baglia/ROSBOT-project/componenti/motori/linmot/1613658636852.jpg

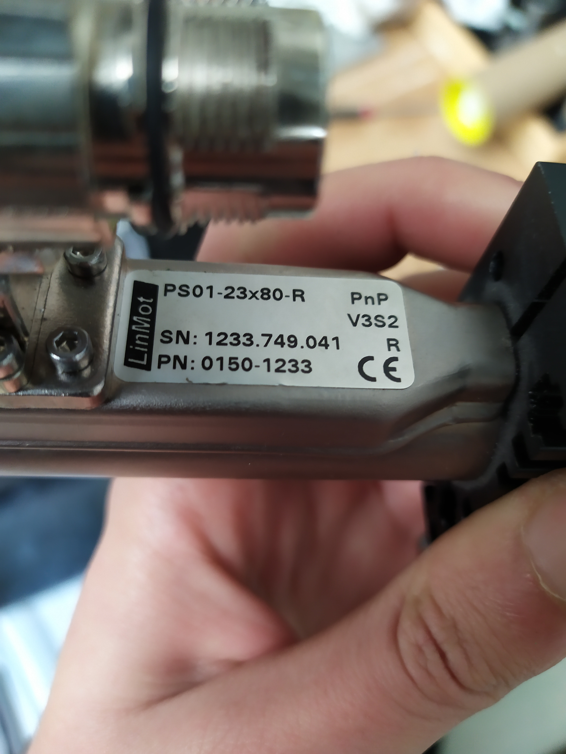
componenti/motori/linmot/1613658636852.jpg
