baglia/ROSBOT-project/README.md

# ROSBOT-project
 Francesco Baglioni e Francesco Campregher hanno realizzato un robot SCARA integrato con ROS come tesi di laurea triennale in ingegneria dell'automazione a UNIBS
