baglia/ROSBOT-project/componenti/motori/linmot/1613397983454.jpg

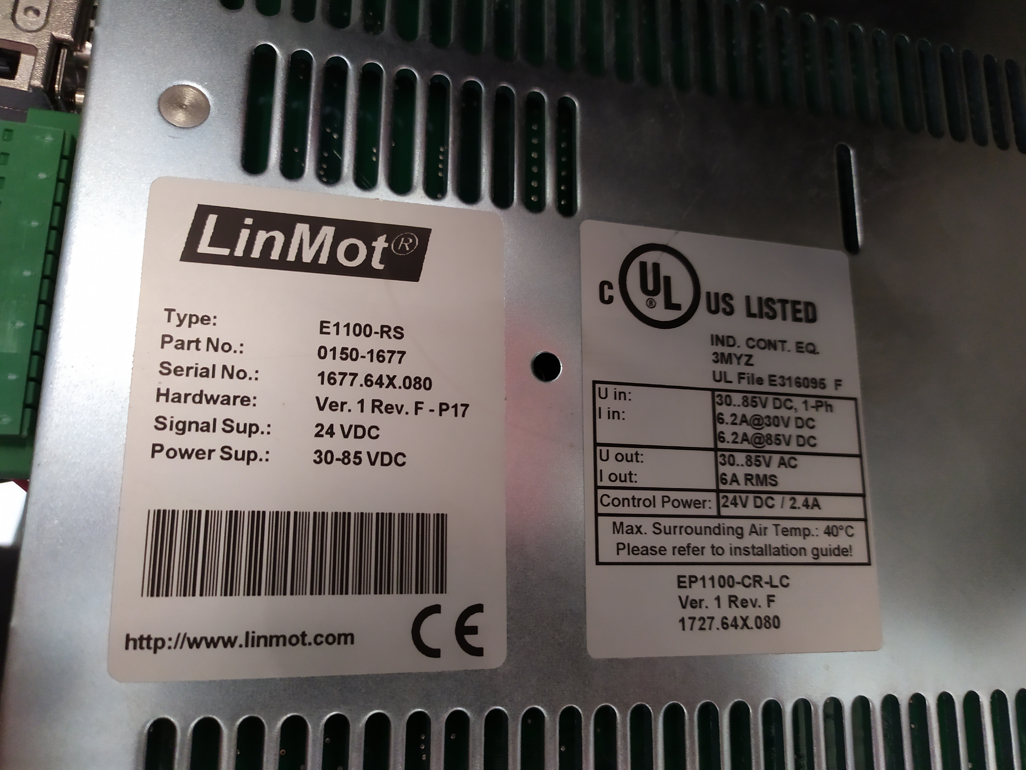
componenti/motori/linmot/1613397983454.jpg
