baglia/ROSBOT-project/componenti/motori/linmot/1613658636869.jpg

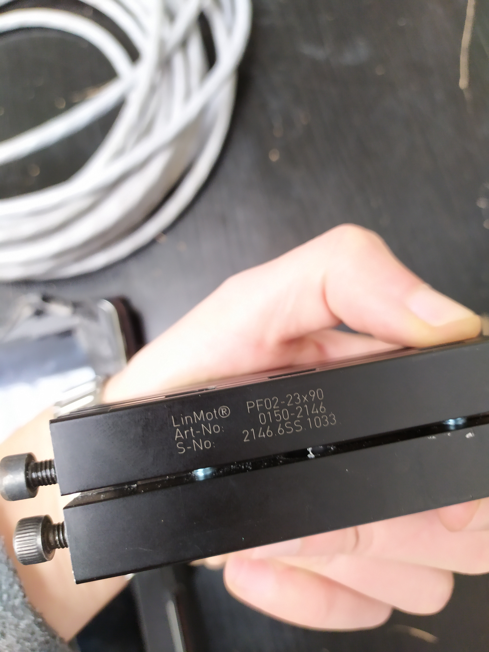
componenti/motori/linmot/1613658636869.jpg
