baglia/ROSBOT-project/componenti/motori/omron/mot-asse1.jpg

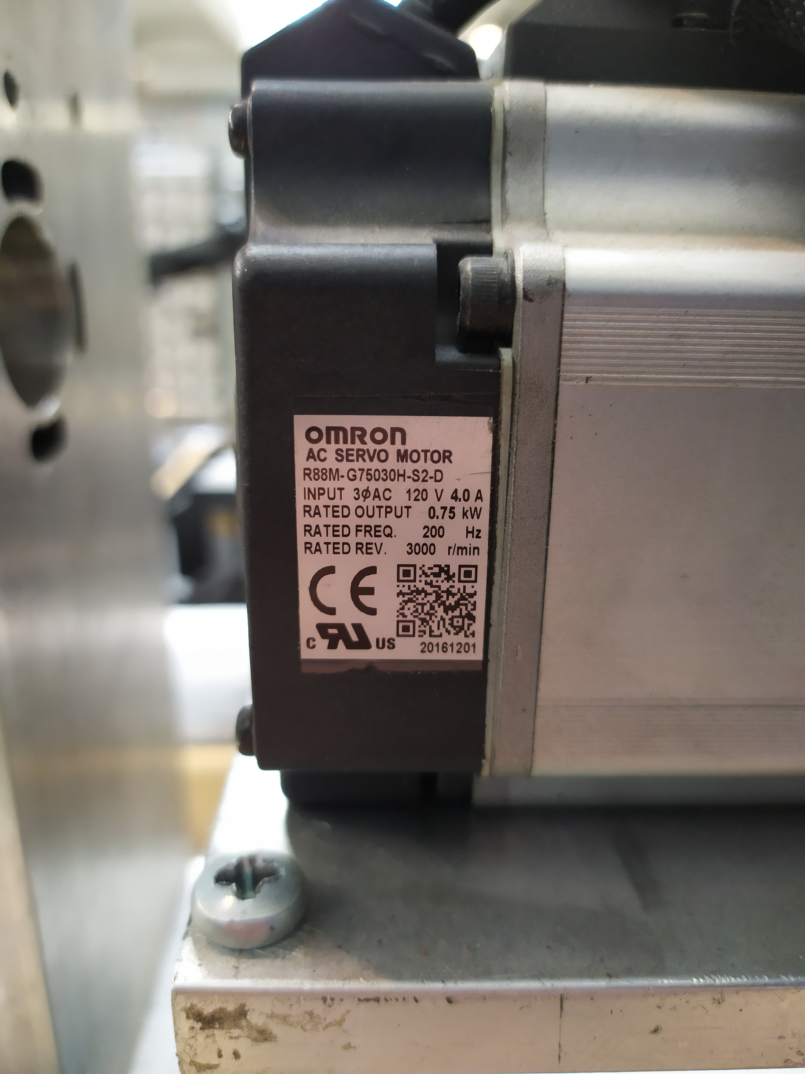
componenti/motori/omron/mot-asse1.jpg
