baglia/ROSBOT-project/componenti/motori/omron/mot-asse2.jpg

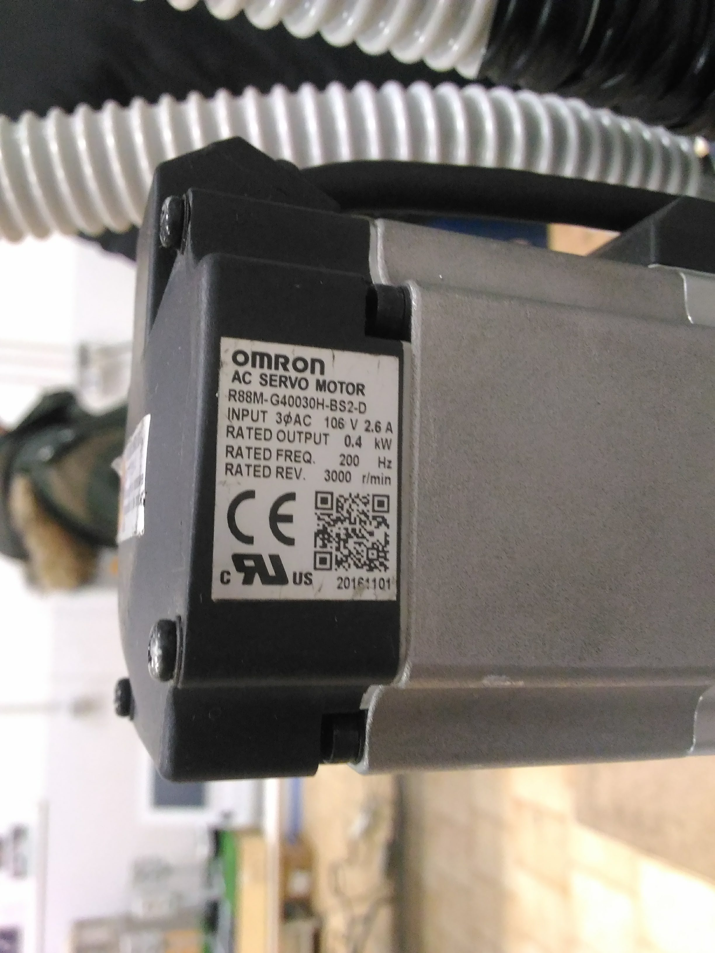
componenti/motori/omron/mot-asse2.jpg
