baglia/ROSBOT-project/componenti/ventosa.jpg

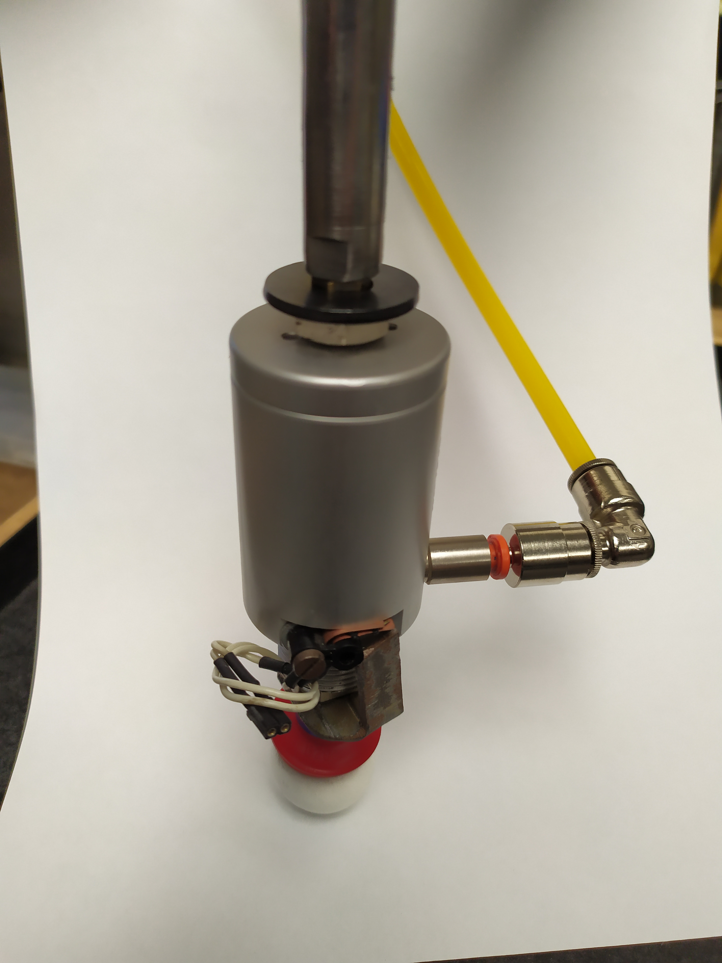
componenti/ventosa.jpg
