baglia/ROSBOT-project/elettronica/scheda_condizionamento/BOM_singola_scheda.pdf

DESCRIZIONE | LINK | CODICE | UNITA
connettore 10 pin maschio | | 732-2094-ND | 9
4 amplificatori operazionali | | 296-1391-5-ND | 17
trimmer 5k 5% | | 987-1067-ND | 5
regolatore di tensione 3.3 V 3.3W | | BR301-ND | 1
array di transistor 400mA | | 497-2344-5-ND | 2
ponte a diodi 600V 0.5 A | | MB6M-E3/45GI-ND | 1
condensatore | | P16730CT-ND | 1
resistenza 2W 100KHom | | OY104KE-ND | 1
potenziometro 2W 5KHom | | 91A1A-B28-A13L-ND | 1
LED 10mA verde | | 1497-1023-ND | 13
sensore temperatura | | TMP37FT9Z-ND | 1
connettori maschio 50 pin 2 righe | | S9176-ND | 5
regolatore di tensione 5V 1A | | BR300-ND | 1
connettore femmina 2 pin | | ED2828-ND | 1
connettore maschio 20 pin 2 file | | 732-2096-ND | 7
connettore femmina 3 pin | | ED2829-ND | 2
shifter logico | | 296-1653-5-ND | 4
strip line 3 pin maschio | | 732-5316-ND | 6
resistenza 1/4 W 200R | | CF14JT200RCT-ND | 12
resistenza 1/4 W 47K | | CF14JT47K0CT-ND | 5
resistenza 1/4 W 4K7 | | CF14JT4K70CT-ND | 5
resistenza 1/4 W 2K | | CF14JT2K00CT-ND | 1
strip line 2 pin maschio | | 732-5315-ND | 2
