baglia/ROSBOT-project/meccanica/SCARA/meccanica/asse1_assieme.SLDASM

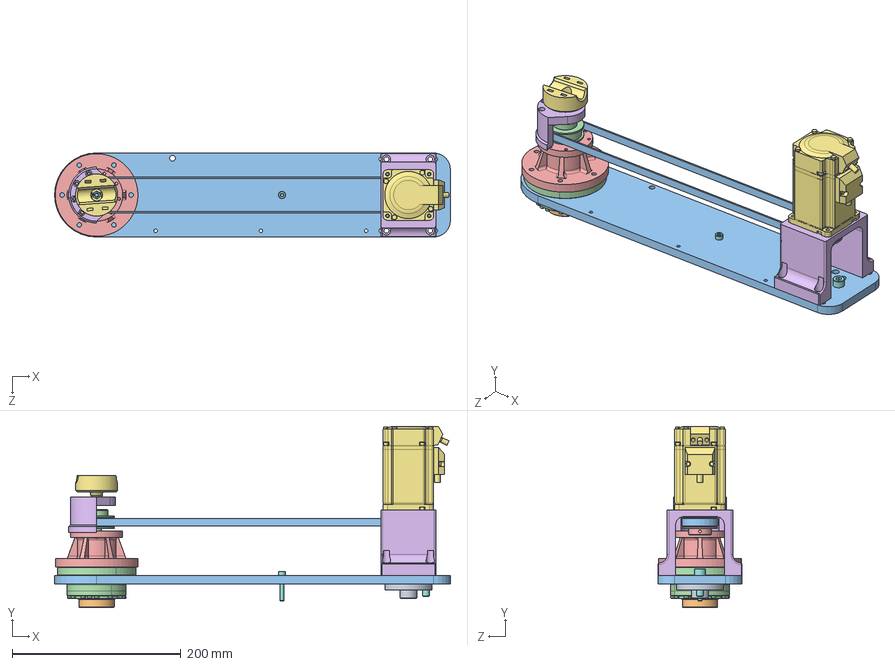
[picture p34: CAD file, 2021-09-06]
meccanica/SCARA/meccanica/asse1_assieme.SLDASM
470.0 x 215.0 x 100.0 mm
centraggio_asse_1
centraggio_asse_2
asse_1
HFUC-20-xx-2UH
banco_cusinetti_1.1
supporto_motore_asse_2
R88M_G40030H_S2
socket head cap screw_iso x 3
ALBERO ASSE 2
12mm Bearing SKF 6201 RS 286-7928 x 2
cinghia
puleggia
puleggia_motore
supporto_cavo_Z
rotante_cavo_z
angular contact ball bearing_68_iso
hex nut gradec_iso
