baglia/ROSBOT-project/meccanica/SCARA/meccanica/totale_assi.SLDASM

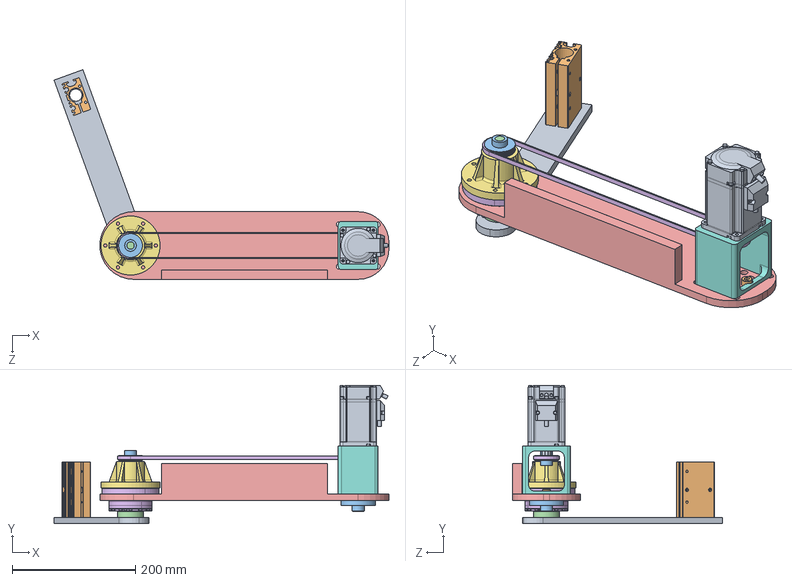
[picture p35: CAD file, 2021-09-06]
meccanica/SCARA/meccanica/totale_assi.SLDASM
544.4 x 225.0 x 340.8 mm
asse_2
0186-0101_090810_PF02-23x90
centraggio_asse_1
centraggio_asse_2
asse_1
HFUC-20-xx-2UH
banco_cusinetti_1.1
supporto_motore_asse_2
R88M_G40030H_S2
socket head cap screw_iso
GT2 2mm T60 x 2
ALBERO ASSE 2
12mm Bearing SKF 6201 RS 286-7928 x 2
cinghia
