baglia/ROSBOT-project/meccanica/SCARA/meccanica/Calcolo_Inerzie.SLDASM

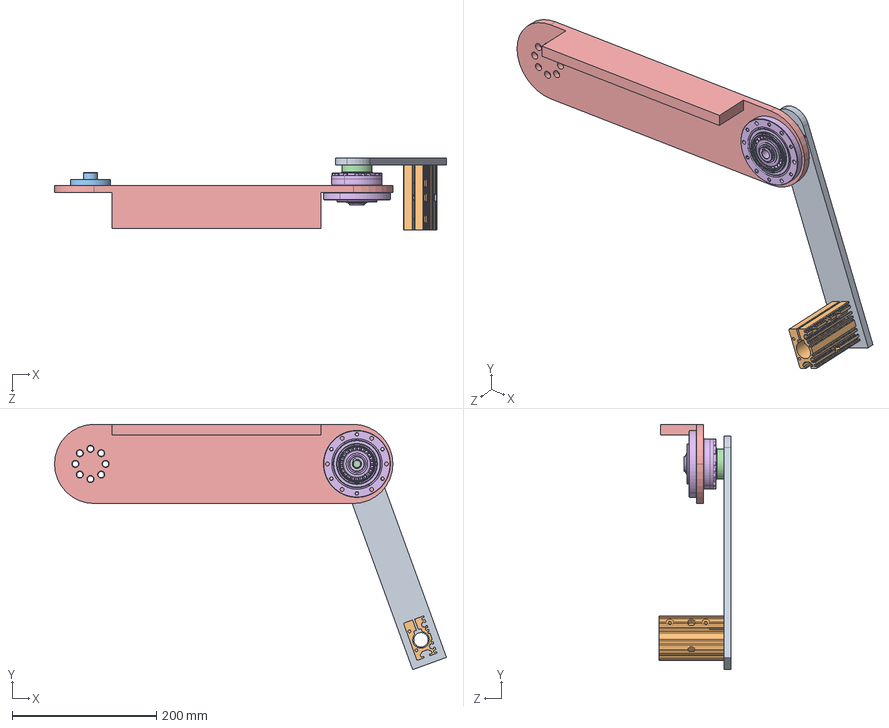
[picture p36: CAD file, 2021-09-06]
meccanica/SCARA/meccanica/Calcolo_Inerzie.SLDASM
544.4 x 340.8 x 100.0 mm
asse_2
0186-0101_090810_PF02-23x90
centraggio_asse_1
centraggio_asse_2
asse_1
HFUC-20-xx-2UH
