baglia/ROSBOT-project/meccanica/SCARA/meccanica/asse2_assieme.SLDASM

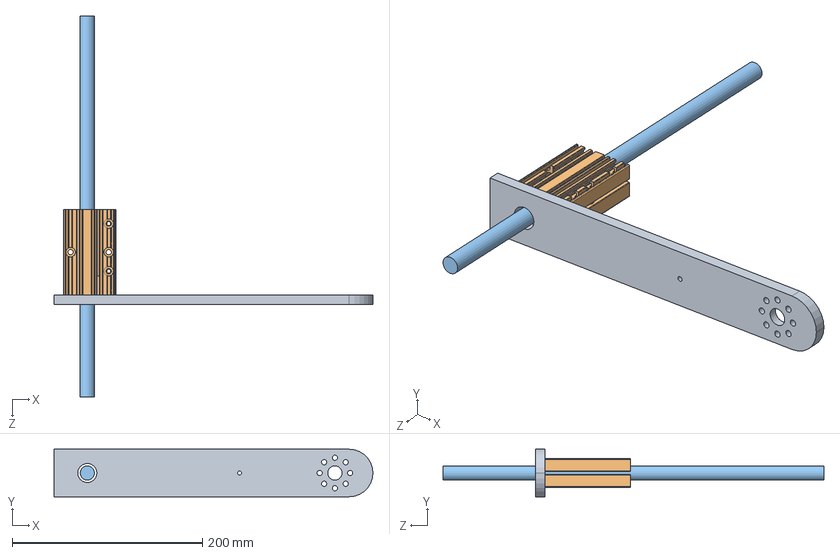
[picture p37: CAD file, 2021-09-06]
meccanica/SCARA/meccanica/asse2_assieme.SLDASM
335.0 x 50.0 x 400.0 mm
asse_2
0186-0101_090810_PF02-23x90
cursore_asse_z
