baglia/ROSBOT-project/elettronica/scheda_condizionamento/comando 24V.step

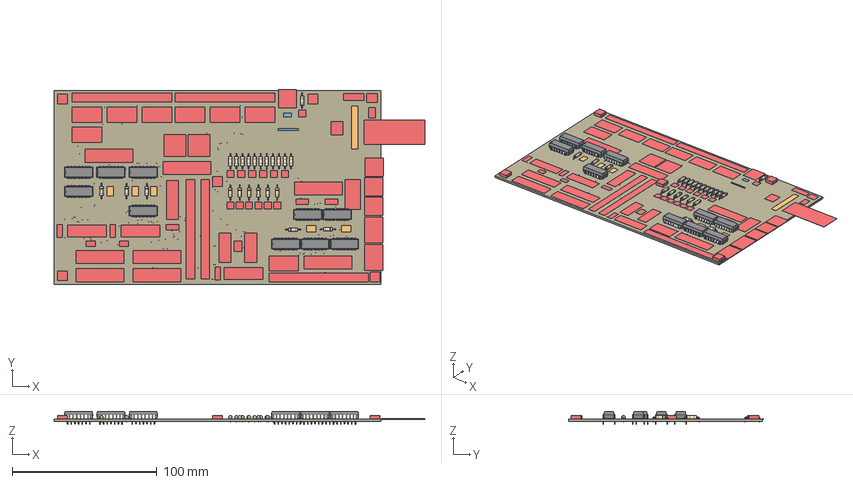
[picture p38: CAD file, 2021-09-06]
elettronica/scheda_condizionamento/comando 24V.step
256.3 x 134.6 x 9.11 mm
Board
CON_2F x 4
B2B-XH-A(LF)(SN)
STRIP_3 x 6
STRIP_2 x 2
LM324N x 10
SBH11-PBPC-D25-ST-BK x 5
CON_3F x 2
POT_2W_5K
200R x 23
VS_EDGE_ADJ x 5
OY104KE
BR30X x 2
LED_TONDO x 13
C0U12F
MB6M-E3/45
ULN2003A x 2
TMP37FT9Z
SN74LS244N x 4
3,3 x 5
H11L1M
QYX1H102JTP3TA
UBY2A301MHL
