baglia/ROSBOT-project/meccanica/AGGIUNTIVI/STAMPA 3D/Supporto_piatto.STL

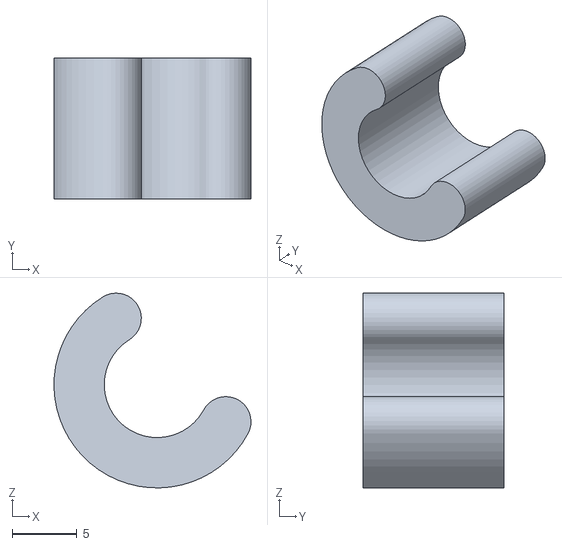
[picture p39: CAD file, 2021-09-06]
meccanica/AGGIUNTIVI/STAMPA 3D/Supporto_piatto.STL
15.3 x 10.9 x 15.1
