baglia/ROSBOT-project/meccanica/AGGIUNTIVI/supporto_palline.SLDPRT

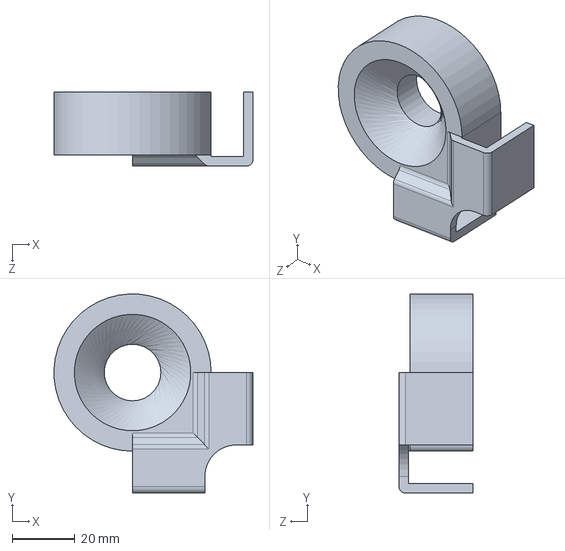
[picture p40: CAD file, 2021-09-06]
meccanica/AGGIUNTIVI/supporto_palline.SLDPRT
63.3 x 63.3 x 23.5 mm
