baglia/ROSBOT-project/meccanica/SCARA/meccanica/STAMPA 3D/interfaccia_motore_asse_1.STL

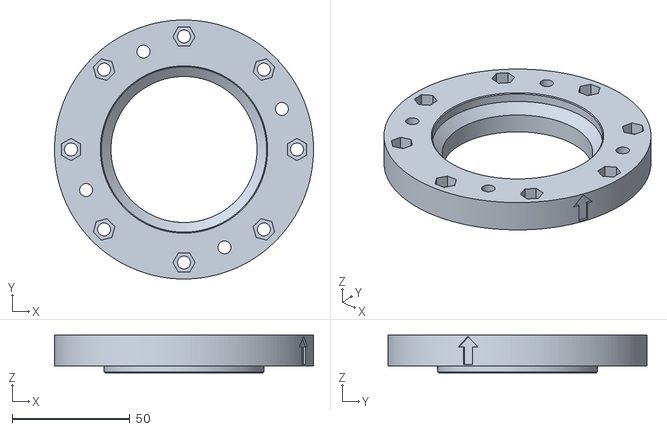
[picture p41: CAD file, 2021-09-06]
meccanica/SCARA/meccanica/STAMPA 3D/interfaccia_motore_asse_1.STL
110.0 x 110.0 x 16.0
