baglia/ROSBOT-project/meccanica/AGGIUNTIVI/supporto_caricatore_verticale.SLDPRT

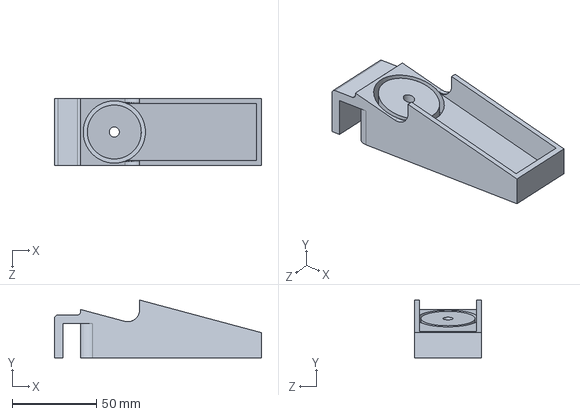
[picture p42: CAD file, 2021-09-06]
meccanica/AGGIUNTIVI/supporto_caricatore_verticale.SLDPRT
122.8 x 34.4 x 40.0 mm
