baglia/ROSBOT-project/meccanica/SCARA/meccanica/STAMPA 3D/tool_fori.STL

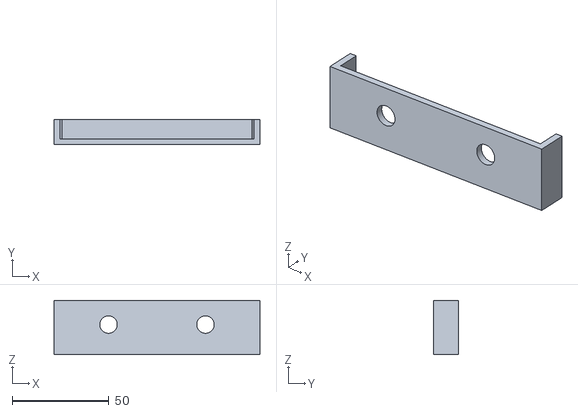
[picture p43: CAD file, 2021-09-06]
meccanica/SCARA/meccanica/STAMPA 3D/tool_fori.STL
106.2 x 13.0 x 28.0
