baglia/ROSBOT-project/meccanica/SCARA/meccanica/supporto_cavo_Z.SLDPRT

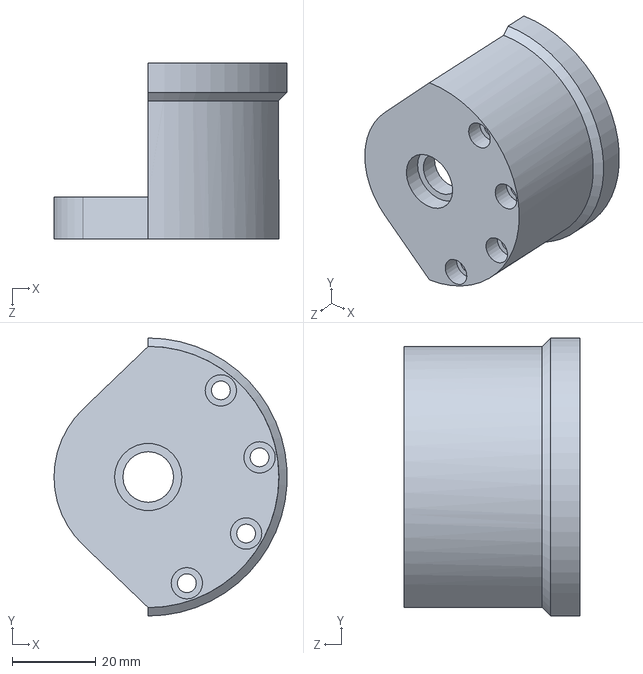
[picture p44: CAD file, 2021-09-06]
meccanica/SCARA/meccanica/supporto_cavo_Z.SLDPRT
55.6 x 66.4 x 42.0 mm
