baglia/ROSBOT-project/meccanica/AGGIUNTIVI/pallet_9_palline.SLDPRT

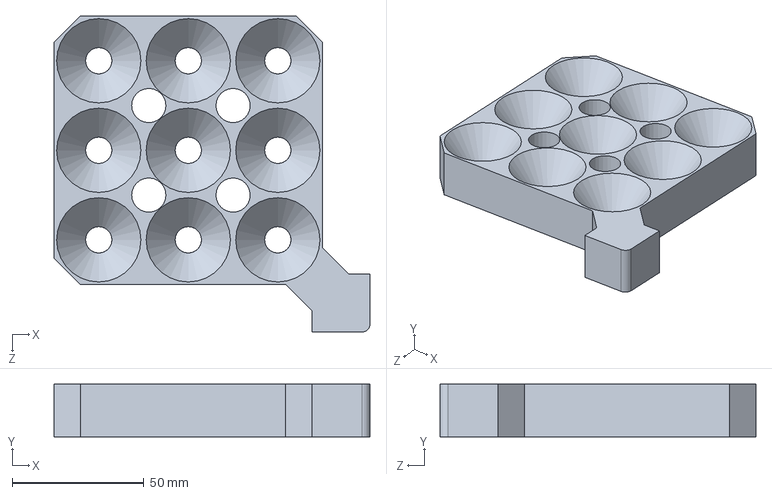
[picture p45: CAD file, 2021-09-06]
meccanica/AGGIUNTIVI/pallet_9_palline.SLDPRT
120.0 x 20.0 x 120.0 mm
