baglia/ROSBOT-project/meccanica/AGGIUNTIVI/STAMPA 3D/FERMI_PIANO.STL

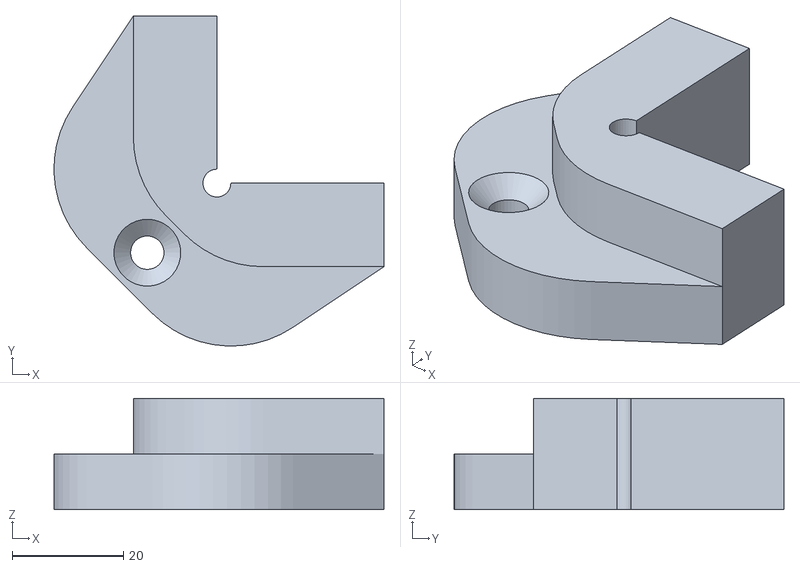
[picture p46: CAD file, 2021-09-06]
meccanica/AGGIUNTIVI/STAMPA 3D/FERMI_PIANO.STL
59.3 x 59.3 x 20.0
