baglia/ROSBOT-project/meccanica/SCARA/meccanica/puleggia.SLDPRT

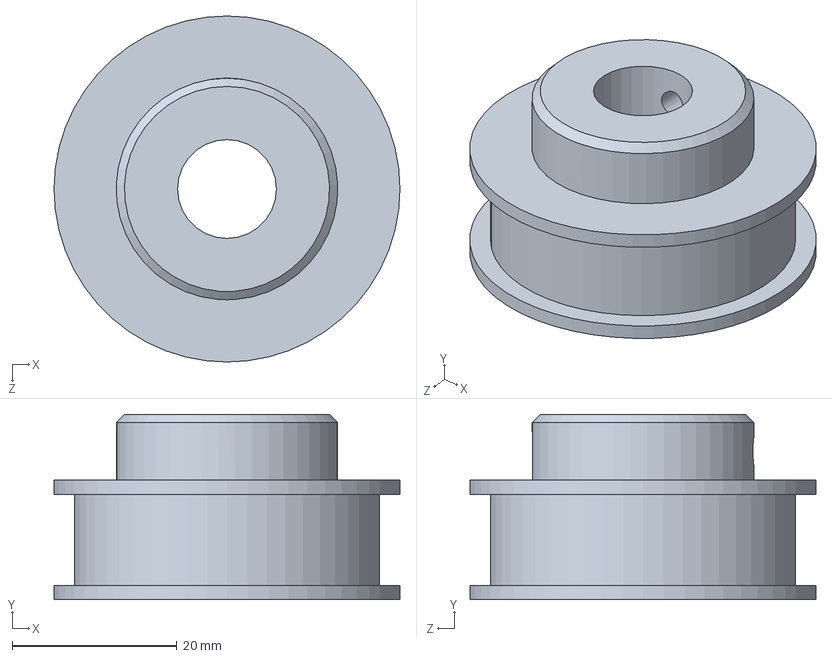
[picture p47: CAD file, 2021-09-06]
meccanica/SCARA/meccanica/puleggia.SLDPRT
42.0 x 22.5 x 42.0 mm
