baglia/ROSBOT-project/meccanica/SCARA/meccanica/STAMPA 3D/supporto_hercules.STL

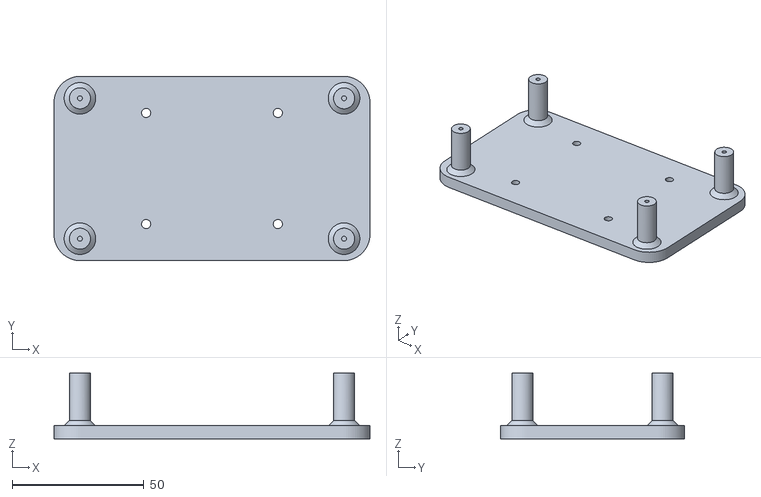
[picture p48: CAD file, 2021-09-06]
meccanica/SCARA/meccanica/STAMPA 3D/supporto_hercules.STL
120.0 x 70.0 x 25.0
