baglia/ROSBOT-project/meccanica/AGGIUNTIVI/caricatore_verticale.SLDPRT

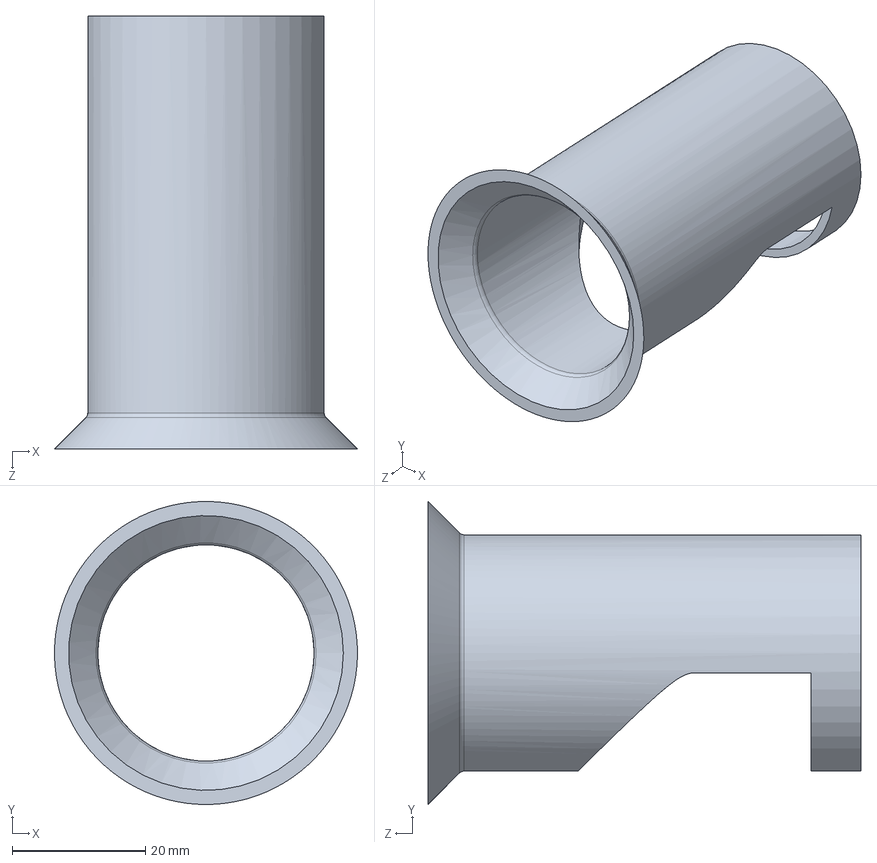
[picture p49: CAD file, 2021-09-06]
meccanica/AGGIUNTIVI/caricatore_verticale.SLDPRT
45.5 x 45.5 x 65.0 mm
