baglia/ROSBOT-project/meccanica/SCARA/meccanica/STAMPA 3D/distanziale_banco_cusinetti.STL

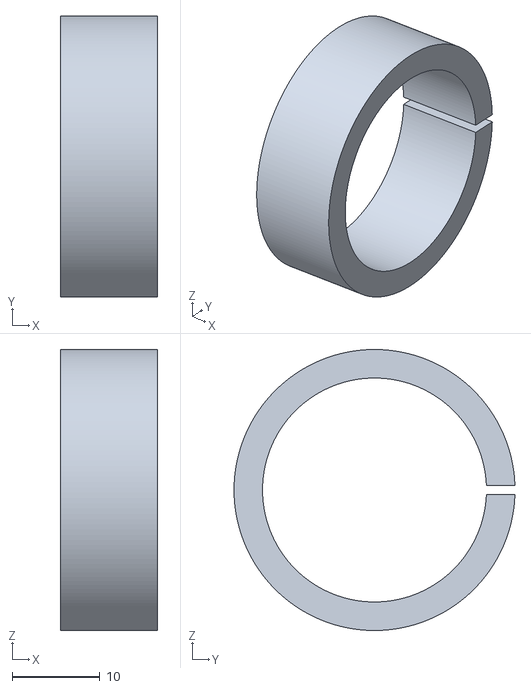
[picture p50: CAD file, 2021-09-06]
meccanica/SCARA/meccanica/STAMPA 3D/distanziale_banco_cusinetti.STL
11.0 x 32.0 x 32.0
