baglia/ROSBOT-project/meccanica/SCARA/meccanica/rotante_cavo_z.SLDPRT

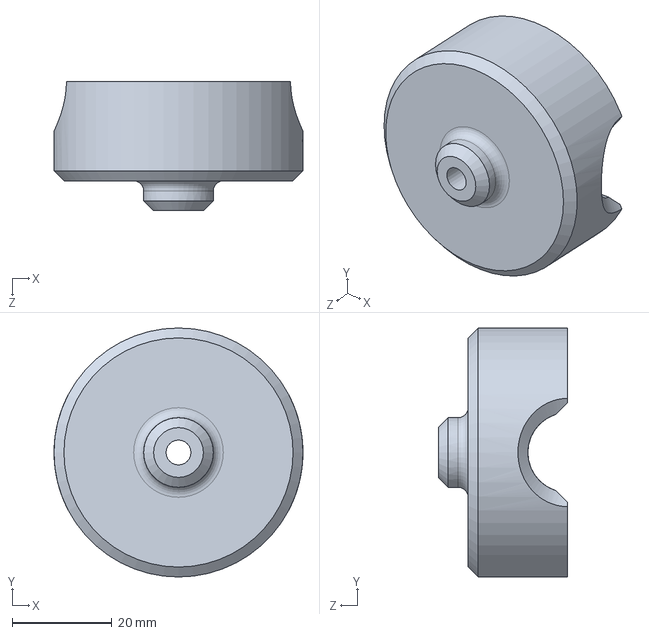
[picture p51: CAD file, 2021-09-06]
meccanica/SCARA/meccanica/rotante_cavo_z.SLDPRT
50.0 x 50.0 x 26.0 mm
