baglia/ROSBOT-project/meccanica/SCARA/meccanica/STAMPA 3D/coprchio_cavi_asse2.STL

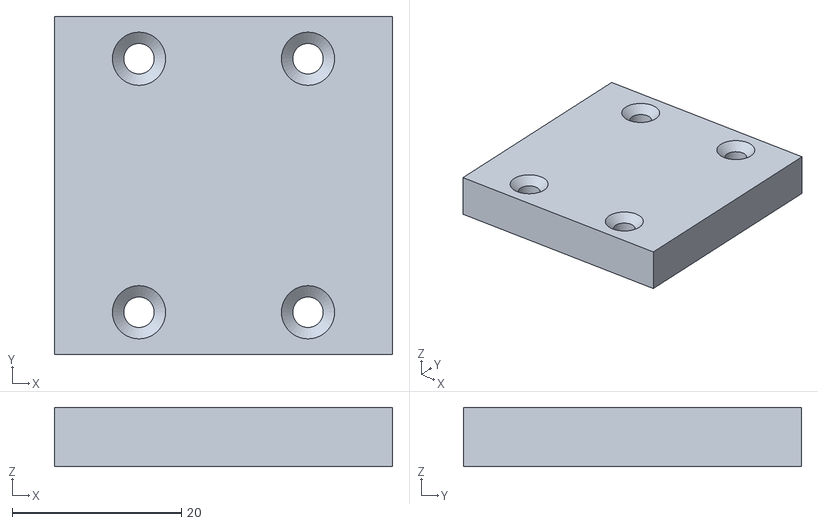
[picture p52: CAD file, 2021-09-06]
meccanica/SCARA/meccanica/STAMPA 3D/coprchio_cavi_asse2.STL
40.0 x 40.0 x 7.00
