baglia/ROSBOT-project/meccanica/SCARA/meccanica/centraggio_asse_1.SLDPRT

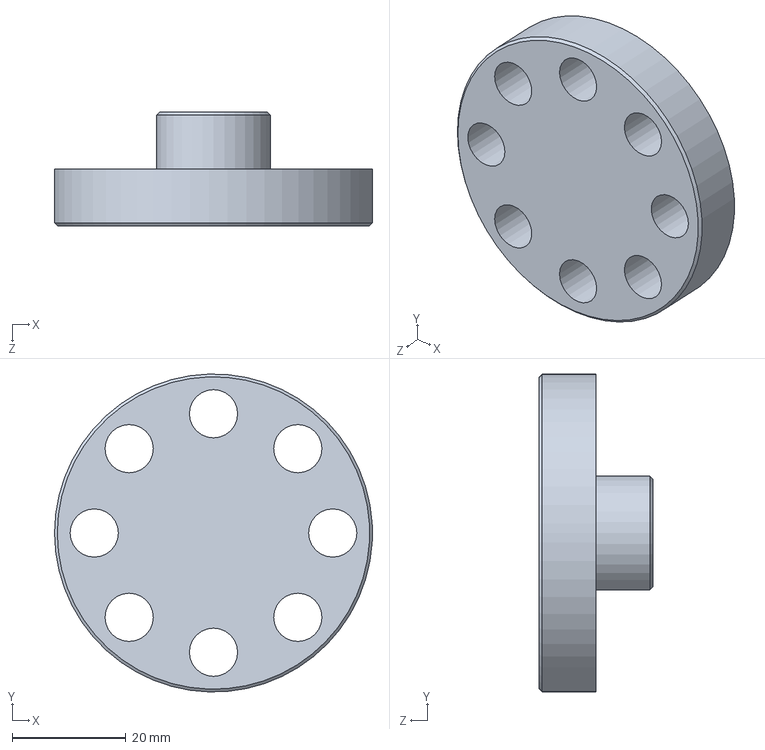
[picture p53: CAD file, 2021-09-06]
meccanica/SCARA/meccanica/centraggio_asse_1.SLDPRT
56.0 x 56.0 x 20.0 mm
