baglia/ROSBOT-project/meccanica/SCARA/meccanica/supporto_asse_1.SLDPRT

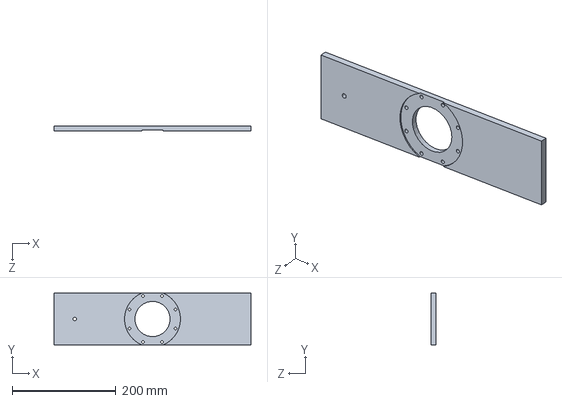
[picture p54: CAD file, 2021-09-06]
meccanica/SCARA/meccanica/supporto_asse_1.SLDPRT
380.0 x 100.0 x 10.0 mm
