baglia/ROSBOT-project/(list of files, cad)

Other CAD files:
software/MICROCONTROLLER/TEXAS INSTRUMENTS HERCULES/CCS_workspace/blink2/Debug/source/HL_sys_main.obj
software/MICROCONTROLLER/TEXAS INSTRUMENTS HERCULES/CCS_workspace/Project1_LAUNCHXL2_RM57L/Debug/demoapp/source/app_main_NoOS.obj
software/MICROCONTROLLER/TEXAS INSTRUMENTS HERCULES/CCS_workspace/seriale/Debug/source/HL_sys_main.obj
software/MICROCONTROLLER/TEXAS INSTRUMENTS HERCULES/CCS_workspace/Blinky_Test/Debug/source/HL_sys_main.obj
software/MICROCONTROLLER/TEXAS INSTRUMENTS HERCULES/CCS_workspace/SCI_UART/Debug/source/HL_sys_main.obj
software/MICROCONTROLLER/TEXAS INSTRUMENTS HERCULES/CCS_workspace/seriale/Release/source/HL_sys_main.obj
software/MICROCONTROLLER/TEXAS INSTRUMENTS HERCULES/CCS_workspace/interrupt/Debug/source/HL_sys_main.obj
software/MICROCONTROLLER/TEXAS INSTRUMENTS HERCULES/CCS_workspace/timmer/Debug/source/HL_sys_main.obj
software/MICROCONTROLLER/TEXAS INSTRUMENTS HERCULES/CCS_workspace/test/Debug/source/HL_sys_main.obj
software/MICROCONTROLLER/TEXAS INSTRUMENTS HERCULES/CCS_workspace/blink/Debug/source/HL_sys_main.obj
software/MICROCONTROLLER/TEXAS INSTRUMENTS HERCULES/CCS_workspace/ADC/Debug/source/HL_sys_main.obj
software/MICROCONTROLLER/TEXAS INSTRUMENTS HERCULES/CCS_workspace/mibSPI/Debug/source/HL_sys_main.obj
software/MICROCONTROLLER/TEXAS INSTRUMENTS HERCULES/CCS_workspace/cinematica_inversa/Debug/source/HL_sys_main.obj
software/MICROCONTROLLER/TEXAS INSTRUMENTS HERCULES/CCS_workspace/led/Debug/source/HL_sys_main.obj
software/MICROCONTROLLER/TEXAS INSTRUMENTS HERCULES/CCS_workspace/blink2/Release/source/HL_sys_main.obj
software/MICROCONTROLLER/TEXAS INSTRUMENTS HERCULES/CCS_workspace/sdCard/Debug/source/HL_sys_main.obj
software/MICROCONTROLLER/TEXAS INSTRUMENTS HERCULES/CCS_workspace/Scara-V1.1/Debug/source/HL_sys_main.obj
software/MICROCONTROLLER/TEXAS INSTRUMENTS HERCULES/CCS_workspace/ADC/Debug/source/HL_sys_pmm.obj
software/MICROCONTROLLER/TEXAS INSTRUMENTS HERCULES/CCS_workspace/blink/Debug/source/HL_pinmux.obj
software/MICROCONTROLLER/TEXAS INSTRUMENTS HERCULES/CCS_workspace/blink2/Debug/source/HL_errata_SSWF021_45.obj
software/MICROCONTROLLER/TEXAS INSTRUMENTS HERCULES/CCS_workspace/blink2/Release/source/HL_errata_SSWF021_45.obj
software/MICROCONTROLLER/TEXAS INSTRUMENTS HERCULES/CCS_workspace/Blinky_Test/Debug/source/HL_sys_pmm.obj
software/MICROCONTROLLER/TEXAS INSTRUMENTS HERCULES/CCS_workspace/cinematica_inversa/Debug/source/HL_sys_pcr.obj
software/MICROCONTROLLER/TEXAS INSTRUMENTS HERCULES/CCS_workspace/interrupt/Debug/source/HL_sys_pmm.obj
software/MICROCONTROLLER/TEXAS INSTRUMENTS HERCULES/CCS_workspace/led/Debug/source/HL_system.obj
software/MICROCONTROLLER/TEXAS INSTRUMENTS HERCULES/CCS_workspace/mibSPI/Debug/source/HL_sys_intvecs.obj
software/MICROCONTROLLER/TEXAS INSTRUMENTS HERCULES/CCS_workspace/Project1_LAUNCHXL2_RM57L/Debug/demoapp/source/misc.obj
software/MICROCONTROLLER/TEXAS INSTRUMENTS HERCULES/CCS_workspace/Project1_LAUNCHXL2_RM57L/Debug/hcg/source/HL_sys_vim.obj
software/MICROCONTROLLER/TEXAS INSTRUMENTS HERCULES/CCS_workspace/Scara-V1.1/Debug/source/HL_nmpu.obj
software/MICROCONTROLLER/TEXAS INSTRUMENTS HERCULES/CCS_workspace/SCI_UART/Debug/source/HL_nmpu.obj
software/MICROCONTROLLER/TEXAS INSTRUMENTS HERCULES/CCS_workspace/sdCard/Debug/source/HL_sys_core.obj
software/MICROCONTROLLER/TEXAS INSTRUMENTS HERCULES/CCS_workspace/seriale/Debug/source/HL_nmpu.obj
software/MICROCONTROLLER/TEXAS INSTRUMENTS HERCULES/CCS_workspace/seriale/Release/source/HL_system.obj
software/MICROCONTROLLER/TEXAS INSTRUMENTS HERCULES/CCS_workspace/test/Debug/source/HL_nmpu.obj
software/MICROCONTROLLER/TEXAS INSTRUMENTS HERCULES/CCS_workspace/timmer/Debug/source/HL_sys_dma.obj
meccanica/AGGIUNTIVI/STAMPA 3D/supporto_palline.STL
software/MICROCONTROLLER/TEXAS INSTRUMENTS HERCULES/CCS_workspace/ADC/Debug/source/HL_epc.obj
software/MICROCONTROLLER/TEXAS INSTRUMENTS HERCULES/CCS_workspace/blink/Debug/source/HL_system.obj
software/MICROCONTROLLER/TEXAS INSTRUMENTS HERCULES/CCS_workspace/blink2/Release/source/HL_pinmux.obj
software/MICROCONTROLLER/TEXAS INSTRUMENTS HERCULES/CCS_workspace/Blinky_Test/Debug/source/HL_rti.obj
software/MICROCONTROLLER/TEXAS INSTRUMENTS HERCULES/CCS_workspace/cinematica_inversa/Debug/source/HL_rti.obj
software/MICROCONTROLLER/TEXAS INSTRUMENTS HERCULES/CCS_workspace/interrupt/Debug/source/HL_sys_mpu.obj
software/MICROCONTROLLER/TEXAS INSTRUMENTS HERCULES/CCS_workspace/led/Debug/source/HL_nmpu.obj
software/MICROCONTROLLER/TEXAS INSTRUMENTS HERCULES/CCS_workspace/mibSPI/Debug/source/HL_sys_pcr.obj
software/MICROCONTROLLER/TEXAS INSTRUMENTS HERCULES/CCS_workspace/Project1_LAUNCHXL2_RM57L/Debug/hcg/source/HL_sys_intvecs.obj
software/MICROCONTROLLER/TEXAS INSTRUMENTS HERCULES/CCS_workspace/Scara-V1.1/Debug/source/HL_rti.obj
software/MICROCONTROLLER/TEXAS INSTRUMENTS HERCULES/CCS_workspace/SCI_UART/Debug/source/HL_sys_mpu.obj
software/MICROCONTROLLER/TEXAS INSTRUMENTS HERCULES/CCS_workspace/sdCard/Debug/source/HL_sys_dma.obj
software/MICROCONTROLLER/TEXAS INSTRUMENTS HERCULES/CCS_workspace/seriale/Release/source/HL_nmpu.obj
software/MICROCONTROLLER/TEXAS INSTRUMENTS HERCULES/CCS_workspace/test/Debug/source/HL_sys_pcr.obj
software/MICROCONTROLLER/TEXAS INSTRUMENTS HERCULES/CCS_workspace/timmer/Debug/source/HL_sys_startup.obj
software/MICROCONTROLLER/TEXAS INSTRUMENTS HERCULES/CCS_workspace/ADC/Debug/source/HL_gio.obj
software/MICROCONTROLLER/TEXAS INSTRUMENTS HERCULES/CCS_workspace/blink/Debug/source/HL_esm.obj
software/MICROCONTROLLER/TEXAS INSTRUMENTS HERCULES/CCS_workspace/blink2/Debug/source/HL_pinmux.obj
software/MICROCONTROLLER/TEXAS INSTRUMENTS HERCULES/CCS_workspace/blink2/Release/source/HL_sys_pmu.obj
software/MICROCONTROLLER/TEXAS INSTRUMENTS HERCULES/CCS_workspace/Blinky_Test/Debug/source/HL_sys_pmu.obj
software/MICROCONTROLLER/TEXAS INSTRUMENTS HERCULES/CCS_workspace/cinematica_inversa/Debug/source/HL_nmpu.obj
software/MICROCONTROLLER/TEXAS INSTRUMENTS HERCULES/CCS_workspace/interrupt/Debug/source/HL_rti.obj
software/MICROCONTROLLER/TEXAS INSTRUMENTS HERCULES/CCS_workspace/led/Debug/source/HL_sys_dma.obj
software/MICROCONTROLLER/TEXAS INSTRUMENTS HERCULES/CCS_workspace/mibSPI/Debug/source/HL_mibspi.obj
software/MICROCONTROLLER/TEXAS INSTRUMENTS HERCULES/CCS_workspace/Project1_LAUNCHXL2_RM57L/Debug/demoapp/source/adc_demos.obj
software/MICROCONTROLLER/TEXAS INSTRUMENTS HERCULES/CCS_workspace/Project1_LAUNCHXL2_RM57L/Debug/hcg/source/HL_adc.obj
software/MICROCONTROLLER/TEXAS INSTRUMENTS HERCULES/CCS_workspace/Scara-V1.1/Debug/source/HL_sys_pcr.obj
software/MICROCONTROLLER/TEXAS INSTRUMENTS HERCULES/CCS_workspace/SCI_UART/Debug/source/HL_epc.obj
software/MICROCONTROLLER/TEXAS INSTRUMENTS HERCULES/CCS_workspace/sdCard/Debug/source/HL_sys_intvecs.obj
software/MICROCONTROLLER/TEXAS INSTRUMENTS HERCULES/CCS_workspace/seriale/Debug/source/HL_sys_phantom.obj
software/MICROCONTROLLER/TEXAS INSTRUMENTS HERCULES/CCS_workspace/seriale/Release/source/HL_epc.obj
software/MICROCONTROLLER/TEXAS INSTRUMENTS HERCULES/CCS_workspace/test/Debug/source/HL_sys_mpu.obj
software/MICROCONTROLLER/TEXAS INSTRUMENTS HERCULES/CCS_workspace/timmer/Debug/source/HL_sys_mpu.obj
meccanica/SCARA/meccanica/supporto_hercules.SLDPRT
software/MICROCONTROLLER/TEXAS INSTRUMENTS HERCULES/CCS_workspace/ADC/Debug/source/HL_errata.obj
software/MICROCONTROLLER/TEXAS INSTRUMENTS HERCULES/CCS_workspace/blink/Debug/source/HL_sys_phantom.obj
software/MICROCONTROLLER/TEXAS INSTRUMENTS HERCULES/CCS_workspace/blink2/Debug/source/HL_sys_vim.obj
software/MICROCONTROLLER/TEXAS INSTRUMENTS HERCULES/CCS_workspace/blink2/Release/source/HL_sys_pmm.obj
software/MICROCONTROLLER/TEXAS INSTRUMENTS HERCULES/CCS_workspace/cinematica_inversa/Debug/source/HL_esm.obj
software/MICROCONTROLLER/TEXAS INSTRUMENTS HERCULES/CCS_workspace/interrupt/Debug/source/HL_nmpu.obj
software/MICROCONTROLLER/TEXAS INSTRUMENTS HERCULES/CCS_workspace/led/Debug/source/HL_sys_pcr.obj
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
