baglia/ROSBOT-project/elettronica/scheda_condizionamento/comando 24V.brd

## EAGLE design elettronica/scheda_condizionamento/comando 24V.brd (2021-09-06)

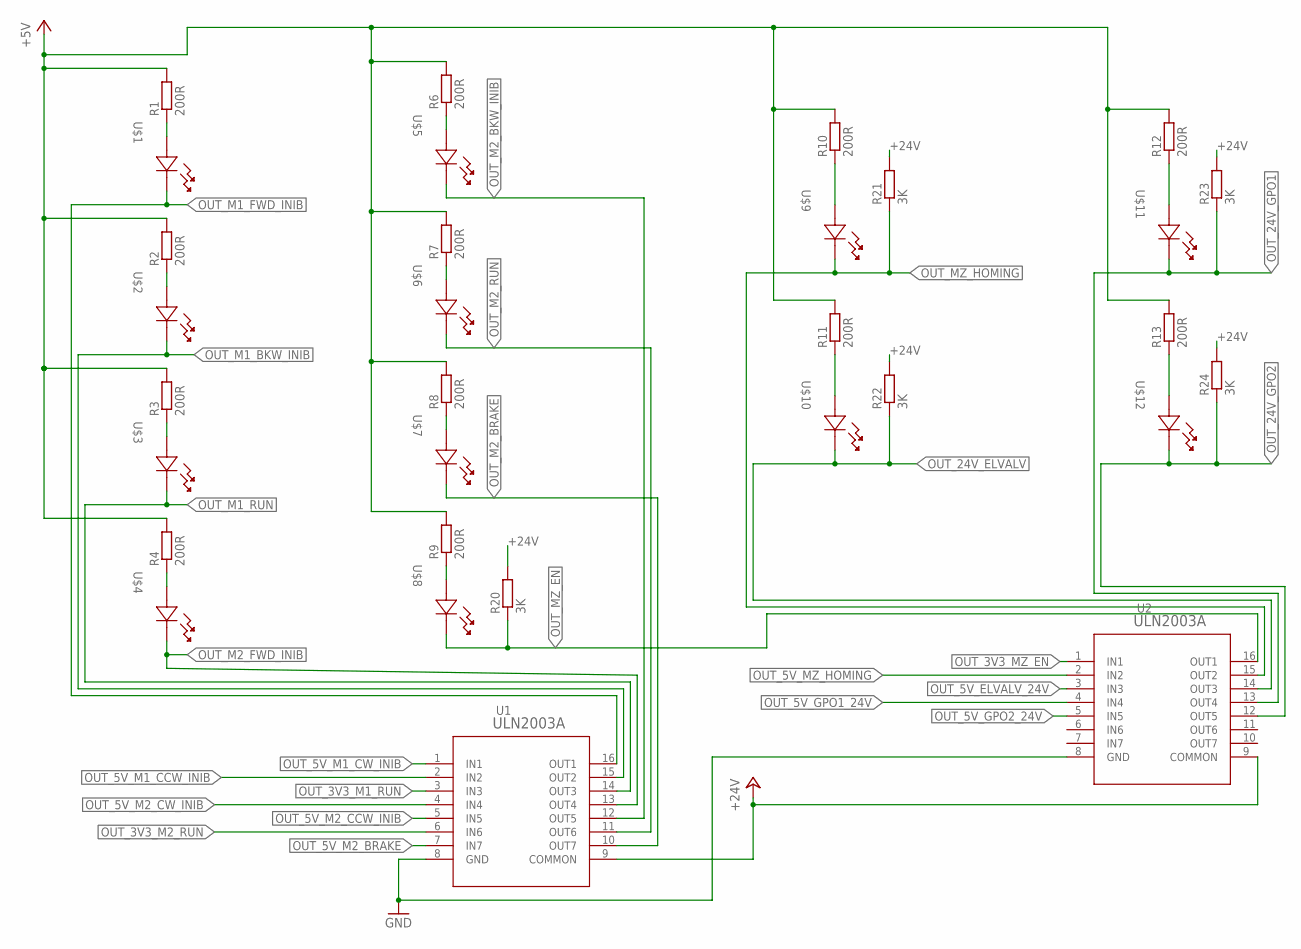
[picture p55: schematic comando 24V.sch, sheet 1]

Parts:
R1, R2, R3, R4, R6, R7, R8, R9, R10, R11, R12, R13: 200R; 0207/10
R20, R21, R22, R23, R24: 3K; 0207/10
U1, U2: ULN2003A; DIP-16_STM
U$1, U$2, U$3, U$4, U$5, U$6, U$7, U$8, U$9, U$10, U$11, U$12: LED_TONDO

Connections:
+5V: R1.2, R2.2, R3.2, R4.2, R6.2, R7.2, R8.2, R9.2, R10.2, R11.2, R12.2, R13.2; also elsewhere on the board
+24V: R20.2, R21.2, R22.2, R23.2, R24.2, U1.9 (COMMON), U2.9 (COMMON); also elsewhere on the board
GND: U1.8 (GND), U2.8 (GND); also elsewhere on the board
unnamed: R1.1, U$1.2
unnamed: R2.1, U$2.2
unnamed: R3.1, U$3.2
unnamed: R4.1, U$4.2
unnamed: R6.1, U$5.2
unnamed: R7.1, U$6.2
unnamed: R8.1, U$7.2
unnamed: R9.1, U$8.2
unnamed: R10.1, U$9.2
unnamed: R11.1, U$10.2
unnamed: R12.1, U$11.2
unnamed: R13.1, U$12.2
OUT_3V3_M1_RUN: U1.3 (IN3); also elsewhere on the board
OUT_3V3_M2_RUN: U1.6 (IN6); also elsewhere on the board
OUT_3V3_MZ_EN: U2.1 (IN1); also elsewhere on the board
OUT_5V_ELVALV_24V: U2.3 (IN3); also elsewhere on the board
OUT_5V_GPO1_24V: U2.4 (IN4); also elsewhere on the board
OUT_5V_GPO2_24V: U2.5 (IN5); also elsewhere on the board
OUT_5V_M1_CCW_INIB: U1.2 (IN2); also elsewhere on the board
OUT_5V_M1_CW_INIB: U1.1 (IN1); also elsewhere on the board
OUT_5V_M2_BRAKE: U1.7 (IN7); also elsewhere on the board
OUT_5V_M2_CCW_INIB: U1.5 (IN5); also elsewhere on the board
OUT_5V_M2_CW_INIB: U1.4 (IN4); also elsewhere on the board
OUT_5V_MZ_HOMING: U2.2 (IN2); also elsewhere on the board
OUT_24V_ELVALV: R22.1, U2.14 (OUT3), U$10.1; also elsewhere on the board
OUT_24V_GPO1: R23.1, U2.13 (OUT4), U$11.1; also elsewhere on the board
OUT_24V_GPO2: R24.1, U2.12 (OUT5), U$12.1; also elsewhere on the board
OUT_M1_BKW_INIB: U1.15 (OUT2), U$2.1; also elsewhere on the board
OUT_M1_FWD_INIB: U1.16 (OUT1), U$1.1; also elsewhere on the board
OUT_M1_RUN: U1.14 (OUT3), U$3.1; also elsewhere on the board
OUT_M2_BKW_INIB: U1.12 (OUT5), U$5.1; also elsewhere on the board
OUT_M2_BRAKE: U1.10 (OUT7), U$7.1; also elsewhere on the board
OUT_M2_FWD_INIB: U1.13 (OUT4), U$4.1; also elsewhere on the board
OUT_M2_RUN: U1.11 (OUT6), U$6.1; also elsewhere on the board
OUT_MZ_EN: R20.1, U2.16 (OUT1), U$8.1; also elsewhere on the board
OUT_MZ_HOMING: R21.1, U2.15 (OUT2), U$9.1; also elsewhere on the board

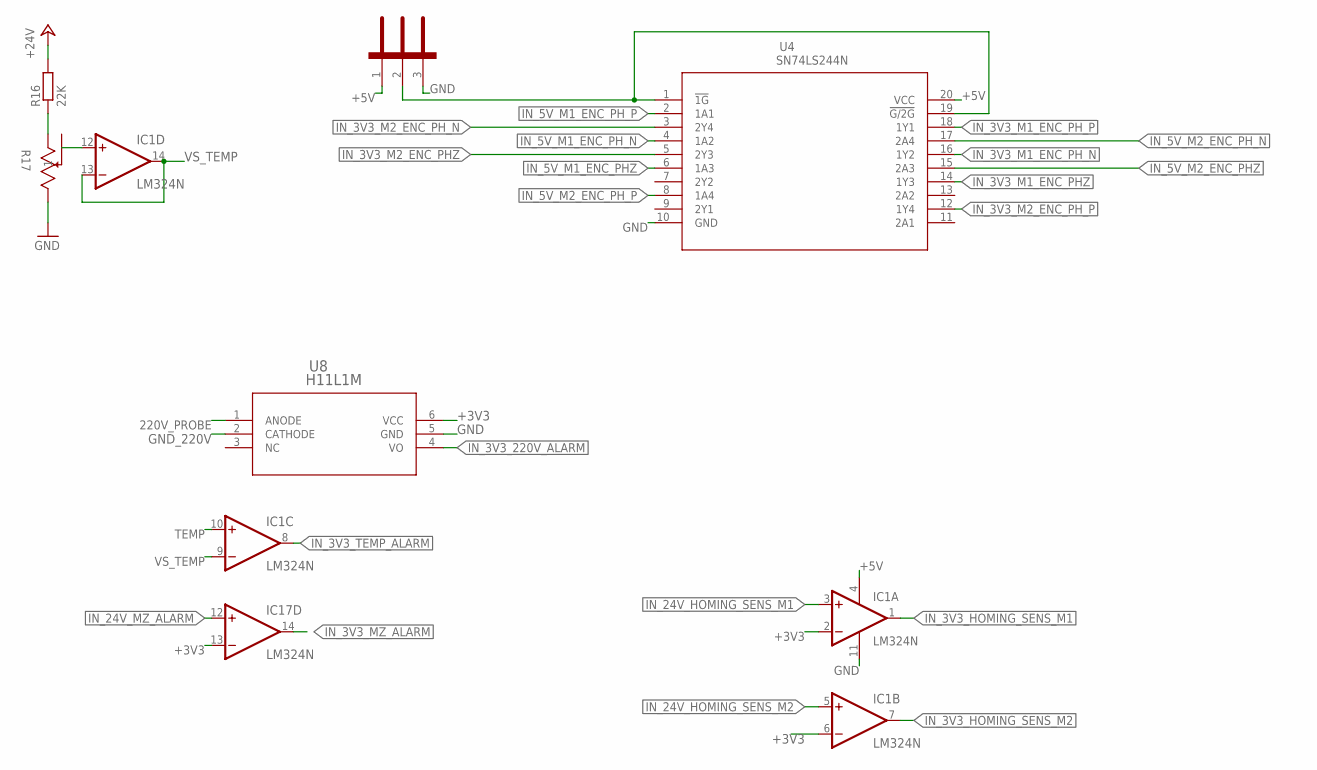
[picture p56: schematic comando 24V.sch, sheet 2]

Parts:
EN_IN_ENC: STRIP_3
IC1, IC17: LM324N; DIL14
R16: 22K; 0207/10
R17: TEMP_ADJ; RES3_64W_TTE
U4: SN74LS244N; N20
U8: H11L1M; PDIP6-646BX_ONS

Connections:
220V_PROBE: U8.1 (ANODE); also elsewhere on the board
+3V3: IC1.2 (-IN), IC1.6 (-IN), IC17.13 (-IN), U8.6 (VCC); also elsewhere on the board
+5V: EN_IN_ENC.1, IC1.4 (V+), U4.20 (VCC); also elsewhere on the board
+24V: R16.2; also elsewhere on the board
GND: EN_IN_ENC.3, IC1.11 (V-), R17.3, U4.10 (GND), U8.5 (GND); also elsewhere on the board
GND_220V: U8.2 (CATHODE); also elsewhere on the board
IN_3V3_220V_ALARM: U8.4 (VO); also elsewhere on the board
IN_3V3_HOMING_SENS_M1: IC1.1 (OUT); also elsewhere on the board
IN_3V3_HOMING_SENS_M2: IC1.7 (OUT); also elsewhere on the board
IN_3V3_M1_ENC_PHZ: U4.14 (1Y3); also elsewhere on the board
IN_3V3_M1_ENC_PH_N: U4.16 (1Y2); also elsewhere on the board
IN_3V3_M1_ENC_PH_P: U4.18 (1Y1); also elsewhere on the board
IN_3V3_M2_ENC_PHZ: U4.5 (2Y3); also elsewhere on the board
IN_3V3_M2_ENC_PH_N: U4.3 (2Y4); also elsewhere on the board
IN_3V3_M2_ENC_PH_P: U4.12 (1Y4); also elsewhere on the board
IN_3V3_MZ_ALARM: IC17.14 (OUT); also elsewhere on the board
IN_3V3_TEMP_ALARM: IC1.8 (OUT); also elsewhere on the board
IN_5V_M1_ENC_PHZ: U4.6 (1A3); also elsewhere on the board
IN_5V_M1_ENC_PH_N: U4.4 (1A2); also elsewhere on the board
IN_5V_M1_ENC_PH_P: U4.2 (1A1); also elsewhere on the board
IN_5V_M2_ENC_PHZ: U4.15 (2A3); also elsewhere on the board
IN_5V_M2_ENC_PH_N: U4.17 (2A4); also elsewhere on the board
IN_5V_M2_ENC_PH_P: U4.8 (1A4); also elsewhere on the board
IN_24V_HOMING_SENS_M1: IC1.3 (+IN); also elsewhere on the board
IN_24V_HOMING_SENS_M2: IC1.5 (+IN); also elsewhere on the board
IN_24V_MZ_ALARM: IC17.12 (+IN); also elsewhere on the board
unnamed: R16.1, R17.1
unnamed: IC1.12 (+IN), R17.2
unnamed: EN_IN_ENC.2, U4.1 (!1G), U4.19 (!G/2G)
TEMP: IC1.10 (+IN); also elsewhere on the board
VS_TEMP: IC1.9 (-IN), IC1.13 (-IN), IC1.14 (OUT)

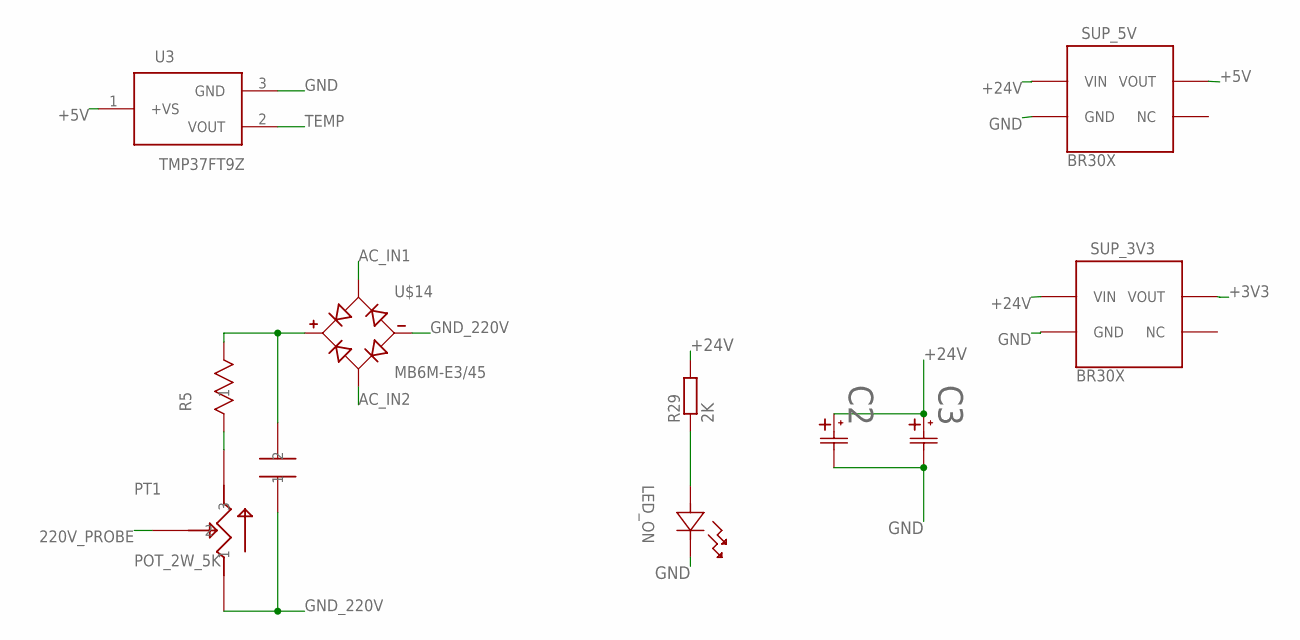
[picture p57: schematic comando 24V.sch, sheet 3]

Parts:
C2: QYX1H102JTP3TA; CAP_QYX_2P5X5X8P5_NCH
C3: UBY2A301MHL; CAP_UBY_12P5X31P5_NCH
PT1: POT_2W_5K
R5: OY104KE; RES_OY_OHM
R29: 2K; 0207/10
SUP_3V3, SUP_5V: BR30X
U3: TMP37FT9Z; T_3_ADI
U$13: C0U12F
U$14: MB6M-E3/45; DIP508W58P254L483H270Q4
U$15: LED_ON; LED_TONDO

Connections:
220V_PROBE: PT1.2; also elsewhere on the board
+3V3: SUP_3V3.VOUT; also elsewhere on the board
+5V: SUP_5V.VOUT, U3.1 (+VS); also elsewhere on the board
+24V: C2.1, C3.1, R29.2, SUP_3V3.VIN, SUP_5V.VIN; also elsewhere on the board
AC_IN1: U$14.3 (AC1); also elsewhere on the board
AC_IN2: U$14.4 (AC2); also elsewhere on the board
GND: C2.2, C3.2, SUP_3V3.GND, SUP_5V.GND, U3.3 (GND), U$15.1; also elsewhere on the board
GND_220V: PT1.1, U$13.P$2 (2), U$14.2 (-); also elsewhere on the board
unnamed: R5.2, U$13.P$1 (1), U$14.1 (+)
unnamed: R29.1, U$15.2
unnamed: PT1.3, R5.1
TEMP: U3.2 (VOUT); also elsewhere on the board

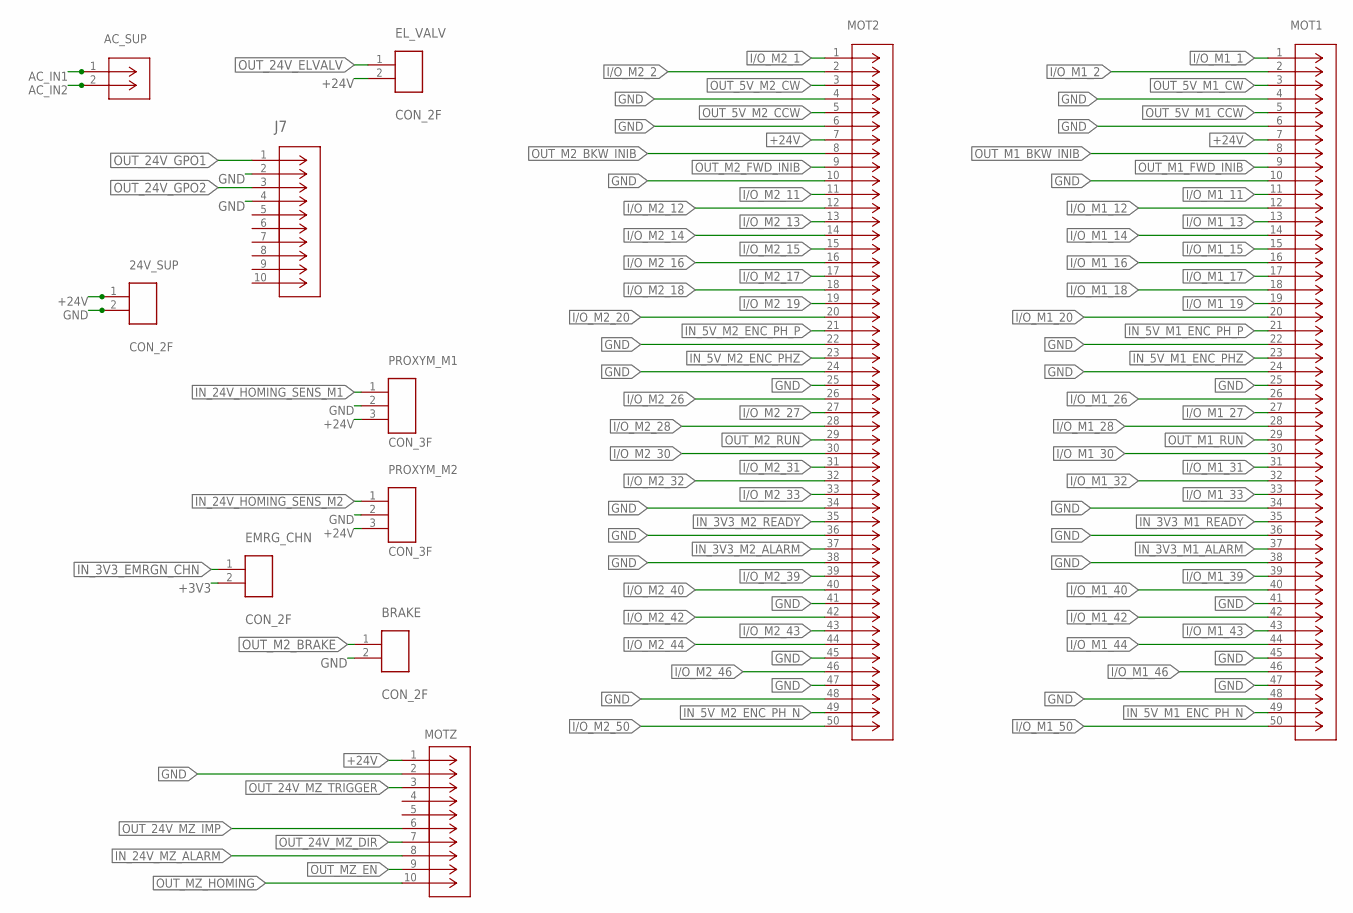
[picture p58: schematic comando 24V.sch, sheet 4]

Parts:
24V_SUP: CON_2F
AC_SUP: B2B-XH-A(LF)(SN); CONN_B2B-XH-A(LF)(SN)_JST
BRAKE: CON_2F
EL_VALV: CON_2F
EMRG_CHN: CON_2F
J7: 61201021621; CONN_61201021621_WRE
MOT1, MOT2: SBH11-PBPC-D25-ST-BK; CONN_SBH11-PBPC-D25-ST-BK_SUL
MOTZ: 61201021621; CONN_61201021621_WRE
PROXYM_M1, PROXYM_M2: CON_3F

Connections:
+3V3: EMRG_CHN.2; also elsewhere on the board
+24V: 24V_SUP.1, EL_VALV.2, MOT1.7, MOT2.7, MOTZ.1, PROXYM_M1.3, PROXYM_M2.3; also elsewhere on the board
AC_IN1: AC_SUP.1; also elsewhere on the board
AC_IN2: AC_SUP.2; also elsewhere on the board
GND: 24V_SUP.2, BRAKE.2, J7.2, J7.4, MOT1.4, MOT1.6, MOT1.10, MOT1.22, MOT1.24, MOT1.25, MOT1.34, MOT1.36, MOT1.38, MOT1.41, MOT1.45, MOT1.47, MOT1.48, MOT2.4, MOT2.6, MOT2.10, MOT2.22, MOT2.24, MOT2.25, MOT2.34, MOT2.36, MOT2.38, MOT2.41, MOT2.45, MOT2.47, MOT2.48, MOTZ.2, PROXYM_M1.2, PROXYM_M2.2; also elsewhere on the board
I/O_M1_1: MOT1.1; also elsewhere on the board
I/O_M1_2: MOT1.2; also elsewhere on the board
I/O_M1_11: MOT1.11; also elsewhere on the board
I/O_M1_12: MOT1.12; also elsewhere on the board
I/O_M1_13: MOT1.13; also elsewhere on the board
I/O_M1_14: MOT1.14; also elsewhere on the board
I/O_M1_15: MOT1.15; also elsewhere on the board
I/O_M1_16: MOT1.16; also elsewhere on the board
I/O_M1_17: MOT1.17; also elsewhere on the board
I/O_M1_18: MOT1.18; also elsewhere on the board
I/O_M1_19: MOT1.19; also elsewhere on the board
I/O_M1_20: MOT1.20; also elsewhere on the board
I/O_M1_26: MOT1.26; also elsewhere on the board
I/O_M1_27: MOT1.27; also elsewhere on the board
I/O_M1_28: MOT1.28; also elsewhere on the board
I/O_M1_30: MOT1.30; also elsewhere on the board
I/O_M1_31: MOT1.31; also elsewhere on the board
I/O_M1_32: MOT1.32; also elsewhere on the board
I/O_M1_33: MOT1.33; also elsewhere on the board
I/O_M1_39: MOT1.39; also elsewhere on the board
I/O_M1_40: MOT1.40; also elsewhere on the board
I/O_M1_42: MOT1.42; also elsewhere on the board
I/O_M1_43: MOT1.43; also elsewhere on the board
I/O_M1_44: MOT1.44; also elsewhere on the board
I/O_M1_46: MOT1.46; also elsewhere on the board
I/O_M1_50: MOT1.50; also elsewhere on the board
I/O_M2_1: MOT2.1; also elsewhere on the board
I/O_M2_2: MOT2.2; also elsewhere on the board
I/O_M2_11: MOT2.11; also elsewhere on the board
I/O_M2_12: MOT2.12; also elsewhere on the board
I/O_M2_13: MOT2.13; also elsewhere on the board
I/O_M2_14: MOT2.14; also elsewhere on the board
I/O_M2_15: MOT2.15; also elsewhere on the board
I/O_M2_16: MOT2.16; also elsewhere on the board
I/O_M2_17: MOT2.17; also elsewhere on the board
I/O_M2_18: MOT2.18; also elsewhere on the board
I/O_M2_19: MOT2.19; also elsewhere on the board
I/O_M2_20: MOT2.20; also elsewhere on the board
I/O_M2_26: MOT2.26; also elsewhere on the board
I/O_M2_27: MOT2.27; also elsewhere on the board
I/O_M2_28: MOT2.28; also elsewhere on the board
I/O_M2_30: MOT2.30; also elsewhere on the board
I/O_M2_31: MOT2.31; also elsewhere on the board
I/O_M2_32: MOT2.32; also elsewhere on the board
I/O_M2_33: MOT2.33; also elsewhere on the board
I/O_M2_39: MOT2.39; also elsewhere on the board
I/O_M2_40: MOT2.40; also elsewhere on the board
I/O_M2_42: MOT2.42; also elsewhere on the board
I/O_M2_43: MOT2.43; also elsewhere on the board
I/O_M2_44: MOT2.44; also elsewhere on the board
I/O_M2_46: MOT2.46; also elsewhere on the board
I/O_M2_50: MOT2.50; also elsewhere on the board
IN_3V3_EMRGN_CHN: EMRG_CHN.1; also elsewhere on the board
IN_3V3_M1_ALARM: MOT1.37; also elsewhere on the board
IN_3V3_M1_READY: MOT1.35; also elsewhere on the board
IN_3V3_M2_ALARM: MOT2.37; also elsewhere on the board
IN_3V3_M2_READY: MOT2.35; also elsewhere on the board
IN_5V_M1_ENC_PHZ: MOT1.23; also elsewhere on the board
IN_5V_M1_ENC_PH_N: MOT1.49; also elsewhere on the board
IN_5V_M1_ENC_PH_P: MOT1.21; also elsewhere on the board
IN_5V_M2_ENC_PHZ: MOT2.23; also elsewhere on the board
IN_5V_M2_ENC_PH_N: MOT2.49; also elsewhere on the board
IN_5V_M2_ENC_PH_P: MOT2.21; also elsewhere on the board
IN_24V_HOMING_SENS_M1: PROXYM_M1.1; also elsewhere on the board
IN_24V_HOMING_SENS_M2: PROXYM_M2.1; also elsewhere on the board
IN_24V_MZ_ALARM: MOTZ.8; also elsewhere on the board
OUT_5V_M1_CCW: MOT1.5; also elsewhere on the board
OUT_5V_M1_CW: MOT1.3; also elsewhere on the board
OUT_5V_M2_CCW: MOT2.5; also elsewhere on the board
OUT_5V_M2_CW: MOT2.3; also elsewhere on the board
OUT_24V_ELVALV: EL_VALV.1; also elsewhere on the board
OUT_24V_GPO1: J7.1; also elsewhere on the board
OUT_24V_GPO2: J7.3; also elsewhere on the board
OUT_24V_MZ_DIR: MOTZ.7; also elsewhere on the board
OUT_24V_MZ_IMP: MOTZ.6; also elsewhere on the board
OUT_24V_MZ_TRIGGER: MOTZ.3; also elsewhere on the board
OUT_M1_BKW_INIB: MOT1.8; also elsewhere on the board
OUT_M1_FWD_INIB: MOT1.9; also elsewhere on the board
OUT_M1_RUN: MOT1.29; also elsewhere on the board
OUT_M2_BKW_INIB: MOT2.8; also elsewhere on the board
OUT_M2_BRAKE: BRAKE.1; also elsewhere on the board
OUT_M2_FWD_INIB: MOT2.9; also elsewhere on the board
OUT_M2_RUN: MOT2.29; also elsewhere on the board
OUT_MZ_EN: MOTZ.9; also elsewhere on the board
OUT_MZ_HOMING: MOTZ.10; also elsewhere on the board

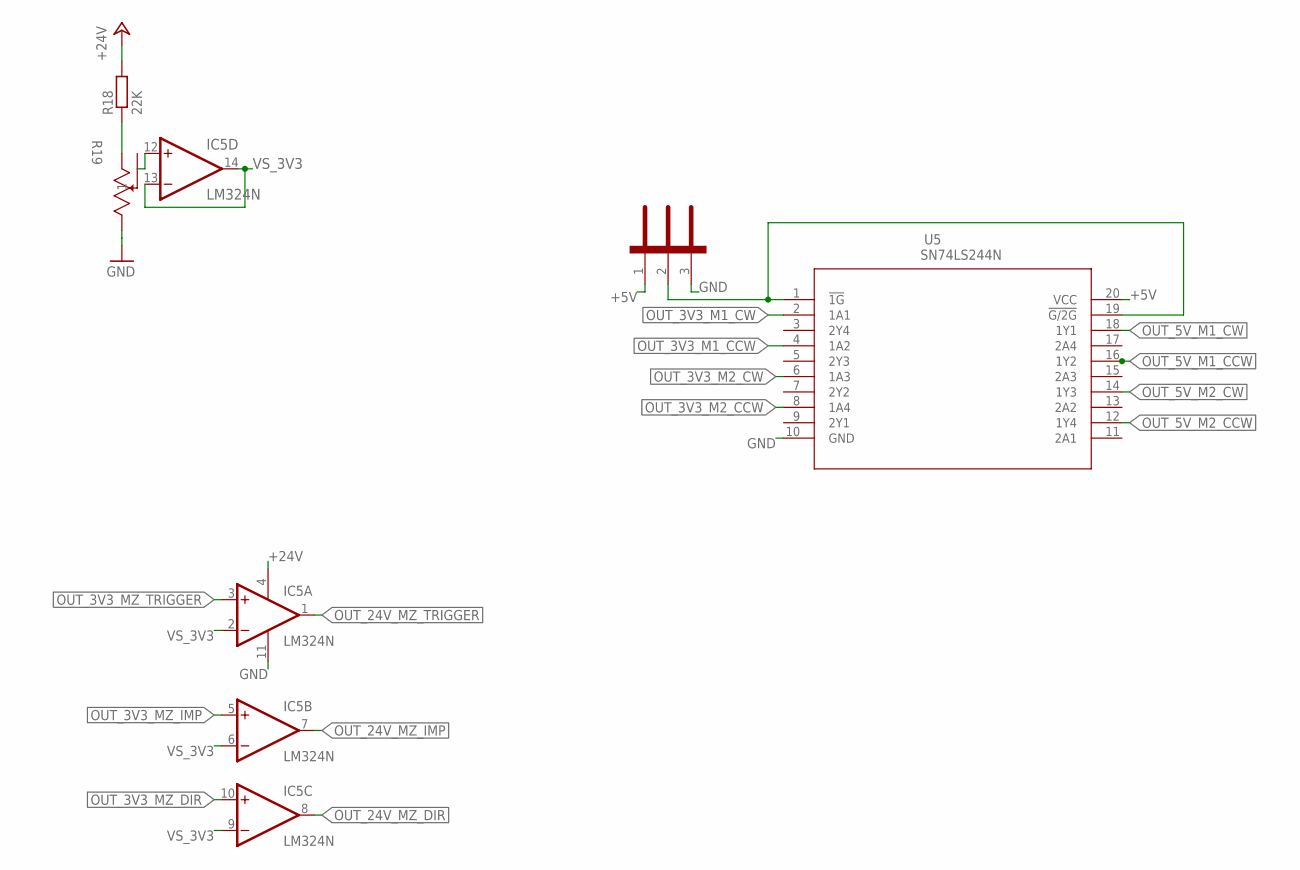
[picture p59: schematic comando 24V.sch, sheet 5]

Parts:
EN_OUT_MOT: STRIP_3
IC5: LM324N; DIL14
R18: 22K; 0207/10
R19: VS_3V3_ADJ; RES3_64W_TTE
U5: SN74LS244N; N20

Connections:
+5V: EN_OUT_MOT.1, U5.20 (VCC); also elsewhere on the board
+24V: IC5.4 (V+), R18.2; also elsewhere on the board
GND: EN_OUT_MOT.3, IC5.11 (V-), R19.3, U5.10 (GND); also elsewhere on the board
unnamed: EN_OUT_MOT.2, U5.1 (!1G), U5.19 (!G/2G)
unnamed: IC5.12 (+IN), R19.2
unnamed: R18.1, R19.1
OUT_3V3_M1_CCW: U5.4 (1A2); also elsewhere on the board
OUT_3V3_M1_CW: U5.2 (1A1); also elsewhere on the board
OUT_3V3_M2_CCW: U5.8 (1A4); also elsewhere on the board
OUT_3V3_M2_CW: U5.6 (1A3); also elsewhere on the board
OUT_3V3_MZ_DIR: IC5.10 (+IN); also elsewhere on the board
OUT_3V3_MZ_IMP: IC5.5 (+IN); also elsewhere on the board
OUT_3V3_MZ_TRIGGER: IC5.3 (+IN); also elsewhere on the board
OUT_5V_M1_CCW: U5.16 (1Y2); also elsewhere on the board
OUT_5V_M1_CW: U5.18 (1Y1); also elsewhere on the board
OUT_5V_M2_CCW: U5.12 (1Y4); also elsewhere on the board
OUT_5V_M2_CW: U5.14 (1Y3); also elsewhere on the board
OUT_24V_MZ_DIR: IC5.8 (OUT); also elsewhere on the board
OUT_24V_MZ_IMP: IC5.7 (OUT); also elsewhere on the board
OUT_24V_MZ_TRIGGER: IC5.1 (OUT); also elsewhere on the board
VS_3V3: IC5.2 (-IN), IC5.6 (-IN), IC5.9 (-IN), IC5.13 (-IN), IC5.14 (OUT)

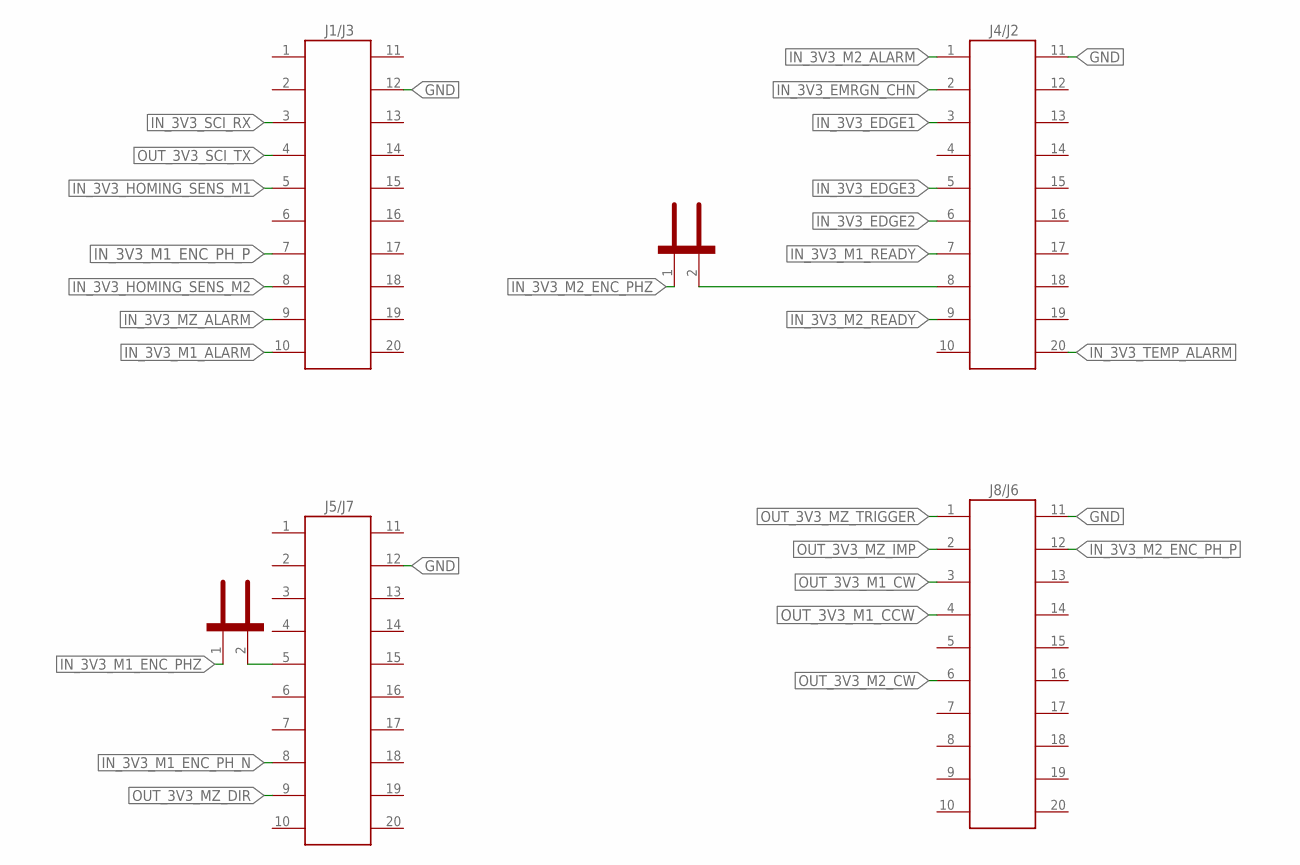
[picture p60: schematic comando 24V.sch, sheet 6]

Parts:
EN_M1_ENC_PHZ, EN_M2_ENC_PHZ: STRIP_2
J1/J3, J4/J2, J5/J7, J8/J6: 61202021621

Connections:
GND: J1/J3.12 (4), J4/J2.11 (2), J5/J7.12 (4), J8/J6.11 (2); also elsewhere on the board
IN_3V3_EDGE1: J4/J2.3 (5); also elsewhere on the board
IN_3V3_EDGE2: J4/J2.6 (11); also elsewhere on the board
IN_3V3_EDGE3: J4/J2.5 (9); also elsewhere on the board
IN_3V3_EMRGN_CHN: J4/J2.2 (3); also elsewhere on the board
IN_3V3_HOMING_SENS_M1: J1/J3.5 (9); also elsewhere on the board
IN_3V3_HOMING_SENS_M2: J1/J3.8 (15); also elsewhere on the board
IN_3V3_M1_ALARM: J1/J3.10 (19); also elsewhere on the board
IN_3V3_M1_ENC_PHZ: EN_M1_ENC_PHZ.1; also elsewhere on the board
IN_3V3_M1_ENC_PH_N: J5/J7.8 (15); also elsewhere on the board
IN_3V3_M1_ENC_PH_P: J1/J3.7 (13); also elsewhere on the board
IN_3V3_M1_READY: J4/J2.7 (13); also elsewhere on the board
IN_3V3_M2_ALARM: J4/J2.1; also elsewhere on the board
IN_3V3_M2_ENC_PHZ: EN_M2_ENC_PHZ.1; also elsewhere on the board
IN_3V3_M2_ENC_PH_P: J8/J6.12 (4); also elsewhere on the board
IN_3V3_M2_READY: J4/J2.9 (17); also elsewhere on the board
IN_3V3_MZ_ALARM: J1/J3.9 (17); also elsewhere on the board
IN_3V3_SCI_RX: J1/J3.3 (5); also elsewhere on the board
IN_3V3_TEMP_ALARM: J4/J2.20; also elsewhere on the board
unnamed: EN_M2_ENC_PHZ.2, J4/J2.8 (15)
unnamed: EN_M1_ENC_PHZ.2, J5/J7.5 (9)
OUT_3V3_M1_CCW: J8/J6.4 (7); also elsewhere on the board
OUT_3V3_M1_CW: J8/J6.3 (5); also elsewhere on the board
OUT_3V3_M2_CW: J8/J6.6 (11); also elsewhere on the board
OUT_3V3_MZ_DIR: J5/J7.9 (17); also elsewhere on the board
OUT_3V3_MZ_IMP: J8/J6.2 (3); also elsewhere on the board
OUT_3V3_MZ_TRIGGER: J8/J6.1; also elsewhere on the board
OUT_3V3_SCI_TX: J1/J3.4 (7); also elsewhere on the board

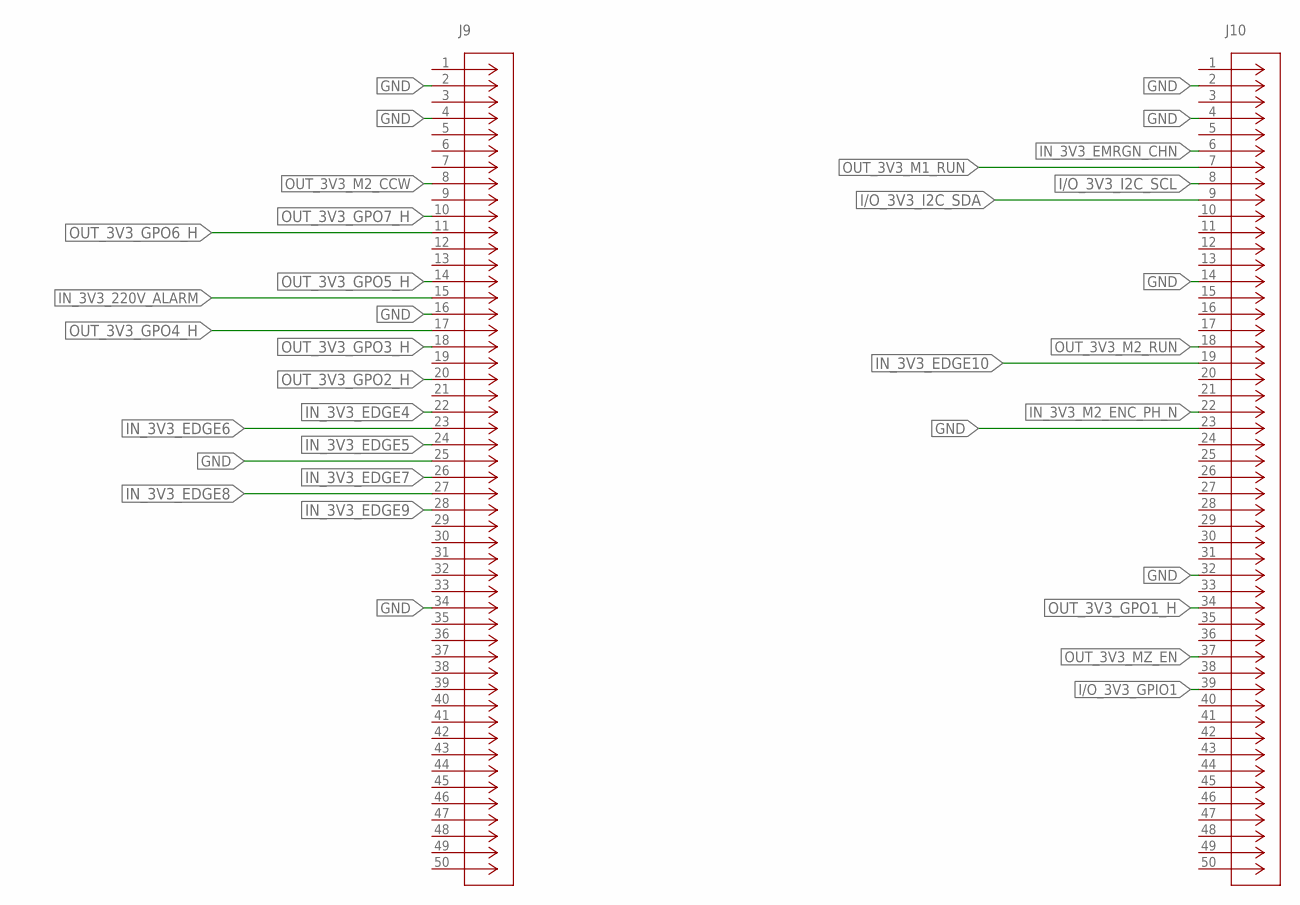
[picture p61: schematic comando 24V.sch, sheet 7]

Parts:
J9, J10: SBH11-PBPC-D25-ST-BK; CONN_SBH11-PBPC-D25-ST-BK_SUL

Connections:
GND: J9.2, J9.4, J9.16, J9.25, J9.34, J10.2, J10.4, J10.14, J10.23, J10.32; also elsewhere on the board
I/O_3V3_GPIO1: J10.39; also elsewhere on the board
I/O_3V3_I2C_SCL: J10.8; also elsewhere on the board
I/O_3V3_I2C_SDA: J10.9; also elsewhere on the board
IN_3V3_220V_ALARM: J9.15; also elsewhere on the board
IN_3V3_EDGE4: J9.22; also elsewhere on the board
IN_3V3_EDGE5: J9.24; also elsewhere on the board
IN_3V3_EDGE6: J9.23; also elsewhere on the board
IN_3V3_EDGE7: J9.26; also elsewhere on the board
IN_3V3_EDGE8: J9.27; also elsewhere on the board
IN_3V3_EDGE9: J9.28; also elsewhere on the board
IN_3V3_EDGE10: J10.19; also elsewhere on the board
IN_3V3_EMRGN_CHN: J10.6; also elsewhere on the board
IN_3V3_M2_ENC_PH_N: J10.22; also elsewhere on the board
OUT_3V3_GPO1_H: J10.34; also elsewhere on the board
OUT_3V3_GPO2_H: J9.20; also elsewhere on the board
OUT_3V3_GPO3_H: J9.18; also elsewhere on the board
OUT_3V3_GPO4_H: J9.17; also elsewhere on the board
OUT_3V3_GPO5_H: J9.14; also elsewhere on the board
OUT_3V3_GPO6_H: J9.11; also elsewhere on the board
OUT_3V3_GPO7_H: J9.10; also elsewhere on the board
OUT_3V3_M1_RUN: J10.7; also elsewhere on the board
OUT_3V3_M2_CCW: J9.8; also elsewhere on the board
OUT_3V3_M2_RUN: J10.18; also elsewhere on the board
OUT_3V3_MZ_EN: J10.37; also elsewhere on the board

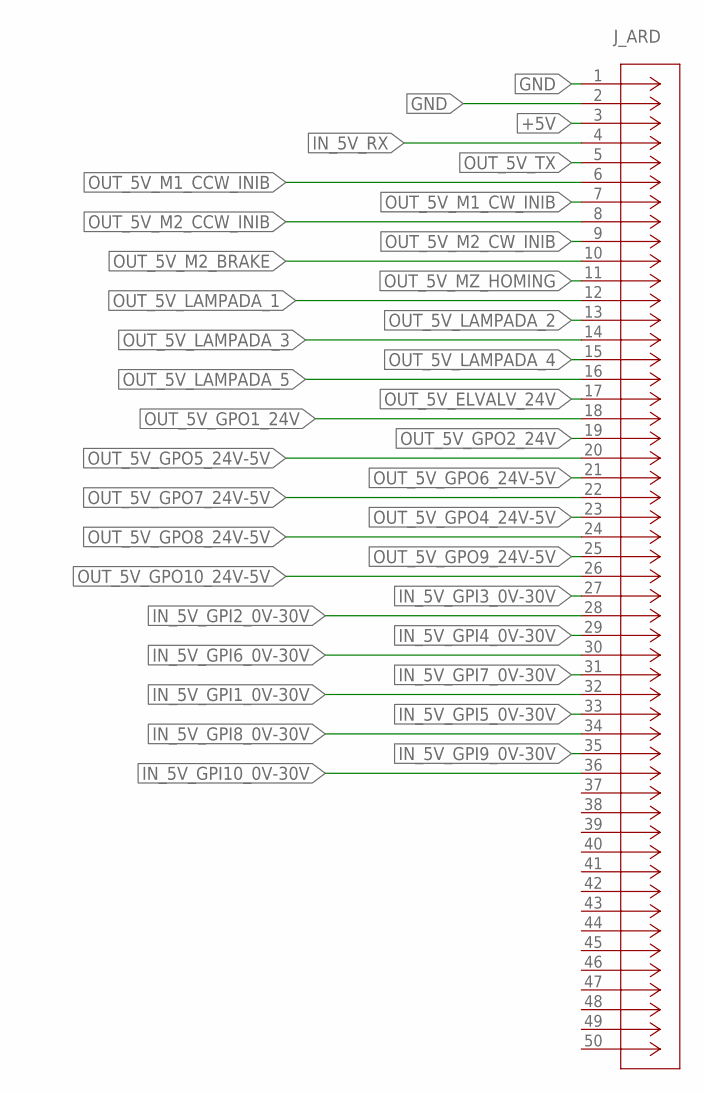
[picture p62: schematic comando 24V.sch, sheet 8]

Parts:
J_ARD: SBH11-PBPC-D25-ST-BK; CONN_SBH11-PBPC-D25-ST-BK_SUL

Connections:
+5V: J_ARD.3; also elsewhere on the board
GND: J_ARD.1, J_ARD.2; also elsewhere on the board
IN_5V_GPI1_0V-30V: J_ARD.32; also elsewhere on the board
IN_5V_GPI2_0V-30V: J_ARD.28; also elsewhere on the board
IN_5V_GPI3_0V-30V: J_ARD.27; also elsewhere on the board
IN_5V_GPI4_0V-30V: J_ARD.29; also elsewhere on the board
IN_5V_GPI5_0V-30V: J_ARD.33; also elsewhere on the board
IN_5V_GPI6_0V-30V: J_ARD.30; also elsewhere on the board
IN_5V_GPI7_0V-30V: J_ARD.31; also elsewhere on the board
IN_5V_GPI8_0V-30V: J_ARD.34; also elsewhere on the board
IN_5V_GPI9_0V-30V: J_ARD.35; also elsewhere on the board
IN_5V_GPI10_0V-30V: J_ARD.36; also elsewhere on the board
IN_5V_RX: J_ARD.4; also elsewhere on the board
OUT_5V_ELVALV_24V: J_ARD.17; also elsewhere on the board
OUT_5V_GPO1_24V: J_ARD.18; also elsewhere on the board
OUT_5V_GPO2_24V: J_ARD.19; also elsewhere on the board
OUT_5V_GPO4_24V-5V: J_ARD.23; also elsewhere on the board
OUT_5V_GPO5_24V-5V: J_ARD.20; also elsewhere on the board
OUT_5V_GPO6_24V-5V: J_ARD.21; also elsewhere on the board
OUT_5V_GPO7_24V-5V: J_ARD.22; also elsewhere on the board
OUT_5V_GPO8_24V-5V: J_ARD.24; also elsewhere on the board
OUT_5V_GPO9_24V-5V: J_ARD.25; also elsewhere on the board
OUT_5V_GPO10_24V-5V: J_ARD.26; also elsewhere on the board
OUT_5V_LAMPADA_1: J_ARD.12; also elsewhere on the board
OUT_5V_LAMPADA_2: J_ARD.13; also elsewhere on the board
OUT_5V_LAMPADA_3: J_ARD.14; also elsewhere on the board
OUT_5V_LAMPADA_4: J_ARD.15; also elsewhere on the board
OUT_5V_LAMPADA_5: J_ARD.16; also elsewhere on the board
OUT_5V_M1_CCW_INIB: J_ARD.6; also elsewhere on the board
OUT_5V_M1_CW_INIB: J_ARD.7; also elsewhere on the board
OUT_5V_M2_BRAKE: J_ARD.10; also elsewhere on the board
OUT_5V_M2_CCW_INIB: J_ARD.8; also elsewhere on the board
OUT_5V_M2_CW_INIB: J_ARD.9; also elsewhere on the board
OUT_5V_MZ_HOMING: J_ARD.11; also elsewhere on the board
OUT_5V_TX: J_ARD.5; also elsewhere on the board

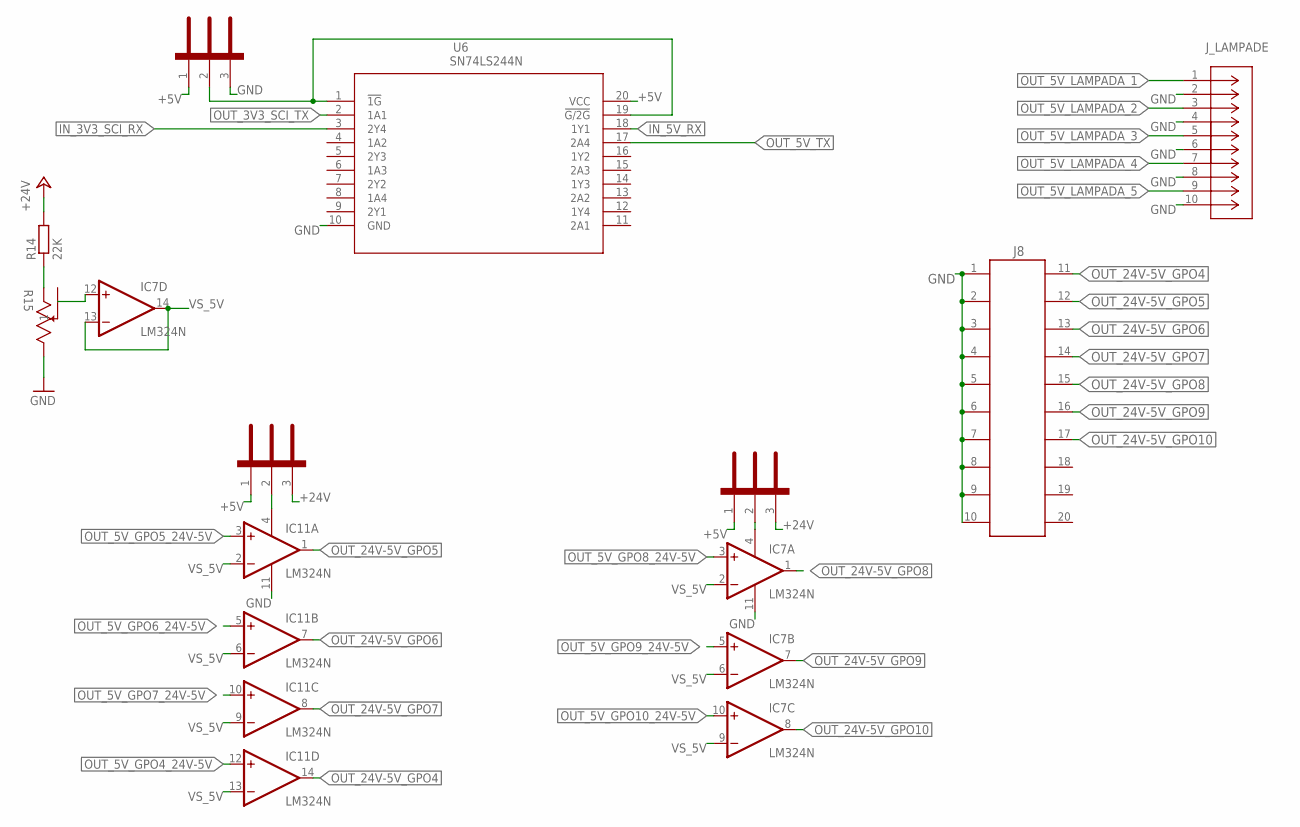
[picture p63: schematic comando 24V.sch, sheet 9]

Parts:
EN_SCI: STRIP_3
IC7, IC11: LM324N; DIL14
J8: 61202021621
J_LAMPADE: 61201021621; CONN_61201021621_WRE
OUT_ARD_4-7_5V-24V, OUT_ARD_8-11_5V-24V: STRIP_3
R14: 22K; 0207/10
R15: VS_5v_ADJ; RES3_64W_TTE
U6: SN74LS244N; N20

Connections:
+5V: EN_SCI.1, OUT_ARD_4-7_5V-24V.1, OUT_ARD_8-11_5V-24V.1, U6.20 (VCC); also elsewhere on the board
+24V: OUT_ARD_4-7_5V-24V.3, OUT_ARD_8-11_5V-24V.3, R14.2; also elsewhere on the board
GND: EN_SCI.3, IC7.11 (V-), IC11.11 (V-), J8.1, J8.2 (3), J8.3 (5), J8.4 (7), J8.5 (9), J8.6 (11), J8.7 (13), J8.8 (15), J8.9 (17), J8.10 (19), J_LAMPADE.2, J_LAMPADE.4, J_LAMPADE.6, J_LAMPADE.8, J_LAMPADE.10, R15.3, U6.10 (GND); also elsewhere on the board
IN_3V3_SCI_RX: U6.3 (2Y4); also elsewhere on the board
IN_5V_RX: U6.18 (1Y1); also elsewhere on the board
unnamed: EN_SCI.2, U6.1 (!1G), U6.19 (!G/2G)
unnamed: R14.1, R15.1
unnamed: IC11.4 (V+), OUT_ARD_4-7_5V-24V.2
unnamed: IC7.4 (V+), OUT_ARD_8-11_5V-24V.2
unnamed: IC7.12 (+IN), R15.2
OUT_3V3_SCI_TX: U6.2 (1A1); also elsewhere on the board
OUT_5V_GPO4_24V-5V: IC11.12 (+IN); also elsewhere on the board
OUT_5V_GPO5_24V-5V: IC11.3 (+IN); also elsewhere on the board
OUT_5V_GPO6_24V-5V: IC11.5 (+IN); also elsewhere on the board
OUT_5V_GPO7_24V-5V: IC11.10 (+IN); also elsewhere on the board
OUT_5V_GPO8_24V-5V: IC7.3 (+IN); also elsewhere on the board
OUT_5V_GPO9_24V-5V: IC7.5 (+IN); also elsewhere on the board
OUT_5V_GPO10_24V-5V: IC7.10 (+IN); also elsewhere on the board
OUT_5V_LAMPADA_1: J_LAMPADE.1; also elsewhere on the board
OUT_5V_LAMPADA_2: J_LAMPADE.3; also elsewhere on the board
OUT_5V_LAMPADA_3: J_LAMPADE.5; also elsewhere on the board
OUT_5V_LAMPADA_4: J_LAMPADE.7; also elsewhere on the board
OUT_5V_LAMPADA_5: J_LAMPADE.9; also elsewhere on the board
OUT_5V_TX: U6.17 (2A4); also elsewhere on the board
OUT_24V-5V_GPO4: IC11.14 (OUT), J8.11 (2)
OUT_24V-5V_GPO5: IC11.1 (OUT), J8.12 (4)
OUT_24V-5V_GPO6: IC11.7 (OUT), J8.13 (6)
OUT_24V-5V_GPO7: IC11.8 (OUT), J8.14 (8)
OUT_24V-5V_GPO8: IC7.1 (OUT), J8.15 (10)
OUT_24V-5V_GPO9: IC7.7 (OUT), J8.16 (12)
OUT_24V-5V_GPO10: IC7.8 (OUT), J8.17 (14)
VS_5V: IC7.2 (-IN), IC7.6 (-IN), IC7.9 (-IN), IC7.13 (-IN), IC7.14 (OUT), IC11.2 (-IN), IC11.6 (-IN), IC11.9 (-IN), IC11.13 (-IN)
