baglia/ROSBOT-project/elettronica/scheda_condizionamento/comando 24V.brd

## EAGLE design elettronica/scheda_condizionamento/comando 24V.brd (continued)

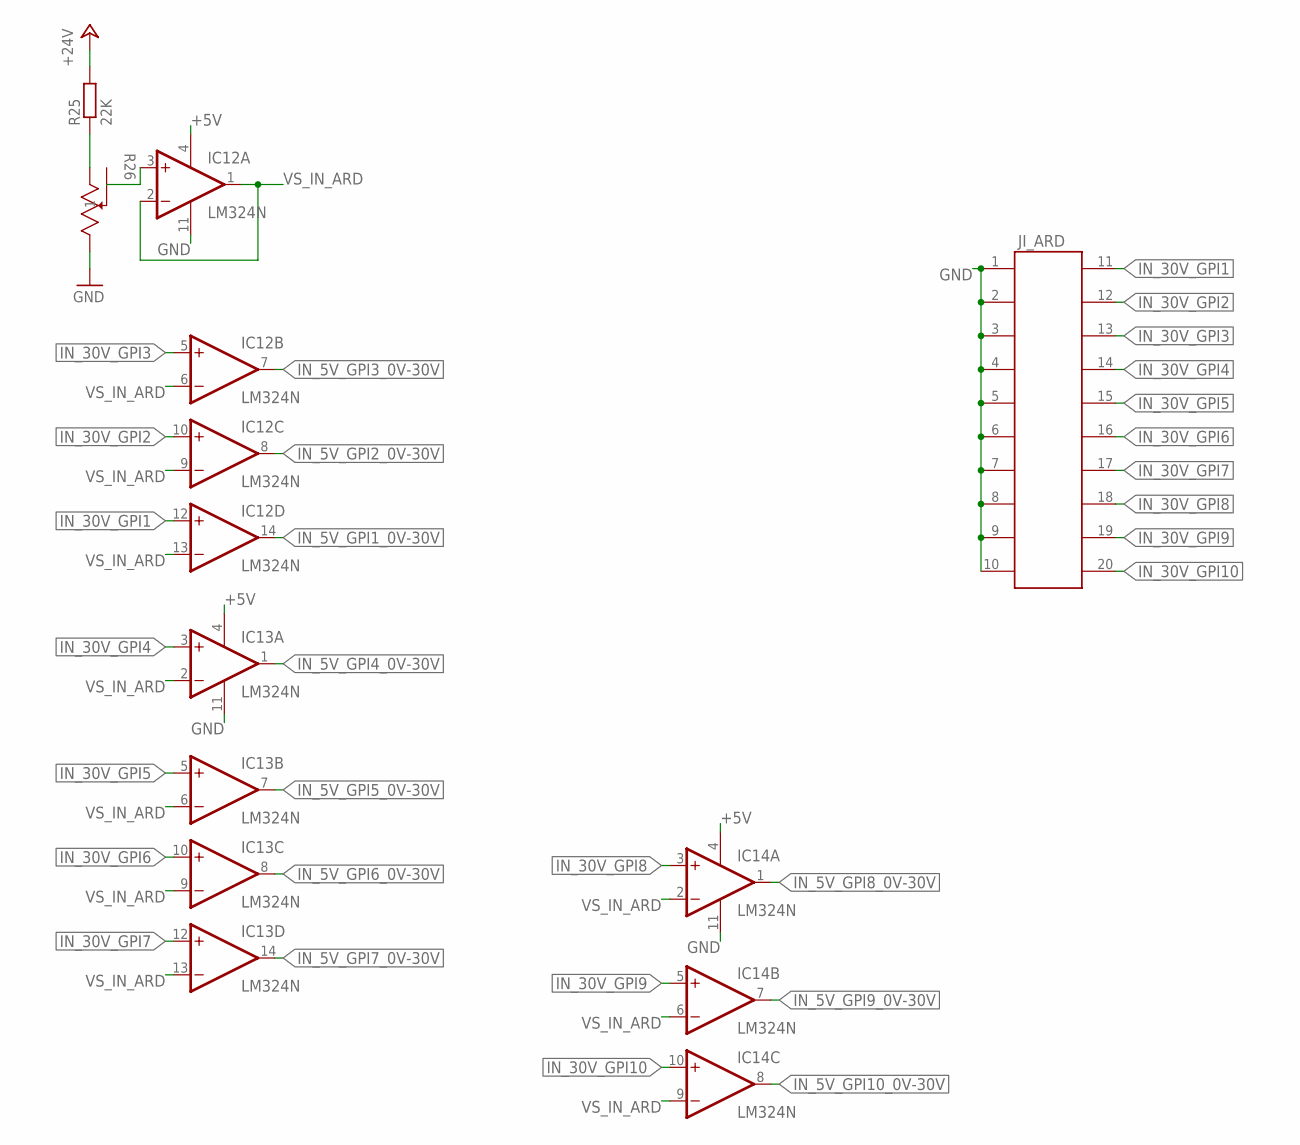
[picture p64: schematic comando 24V.sch, sheet 10]

Parts:
IC12, IC13, IC14: LM324N; DIL14
JI_ARD: 61202021621
R25: 22K; 0207/10
R26: VS_ARD_ADJ; RES3_64W_TTE

Connections:
+5V: IC12.4 (V+), IC13.4 (V+), IC14.4 (V+); also elsewhere on the board
+24V: R25.2; also elsewhere on the board
GND: IC12.11 (V-), IC13.11 (V-), IC14.11 (V-), JI_ARD.1, JI_ARD.2 (3), JI_ARD.3 (5), JI_ARD.4 (7), JI_ARD.5 (9), JI_ARD.6 (11), JI_ARD.7 (13), JI_ARD.8 (15), JI_ARD.9 (17), JI_ARD.10 (19), R26.3; also elsewhere on the board
IN_5V_GPI1_0V-30V: IC12.14 (OUT); also elsewhere on the board
IN_5V_GPI2_0V-30V: IC12.8 (OUT); also elsewhere on the board
IN_5V_GPI3_0V-30V: IC12.7 (OUT); also elsewhere on the board
IN_5V_GPI4_0V-30V: IC13.1 (OUT); also elsewhere on the board
IN_5V_GPI5_0V-30V: IC13.7 (OUT); also elsewhere on the board
IN_5V_GPI6_0V-30V: IC13.8 (OUT); also elsewhere on the board
IN_5V_GPI7_0V-30V: IC13.14 (OUT); also elsewhere on the board
IN_5V_GPI8_0V-30V: IC14.1 (OUT); also elsewhere on the board
IN_5V_GPI9_0V-30V: IC14.7 (OUT); also elsewhere on the board
IN_5V_GPI10_0V-30V: IC14.8 (OUT); also elsewhere on the board
IN_30V_GPI1: IC12.12 (+IN), JI_ARD.11 (2)
IN_30V_GPI2: IC12.10 (+IN), JI_ARD.12 (4)
IN_30V_GPI3: IC12.5 (+IN), JI_ARD.13 (6)
IN_30V_GPI4: IC13.3 (+IN), JI_ARD.14 (8)
IN_30V_GPI5: IC13.5 (+IN), JI_ARD.15 (10)
IN_30V_GPI6: IC13.10 (+IN), JI_ARD.16 (12)
IN_30V_GPI7: IC13.12 (+IN), JI_ARD.17 (14)
IN_30V_GPI8: IC14.3 (+IN), JI_ARD.18 (16)
IN_30V_GPI9: IC14.5 (+IN), JI_ARD.19 (18)
IN_30V_GPI10: IC14.10 (+IN), JI_ARD.20
unnamed: R25.1, R26.1
unnamed: IC12.3 (+IN), R26.2
VS_IN_ARD: IC12.1 (OUT), IC12.2 (-IN), IC12.6 (-IN), IC12.9 (-IN), IC12.13 (-IN), IC13.2 (-IN), IC13.6 (-IN), IC13.9 (-IN), IC13.13 (-IN), IC14.2 (-IN), IC14.6 (-IN), IC14.9 (-IN)

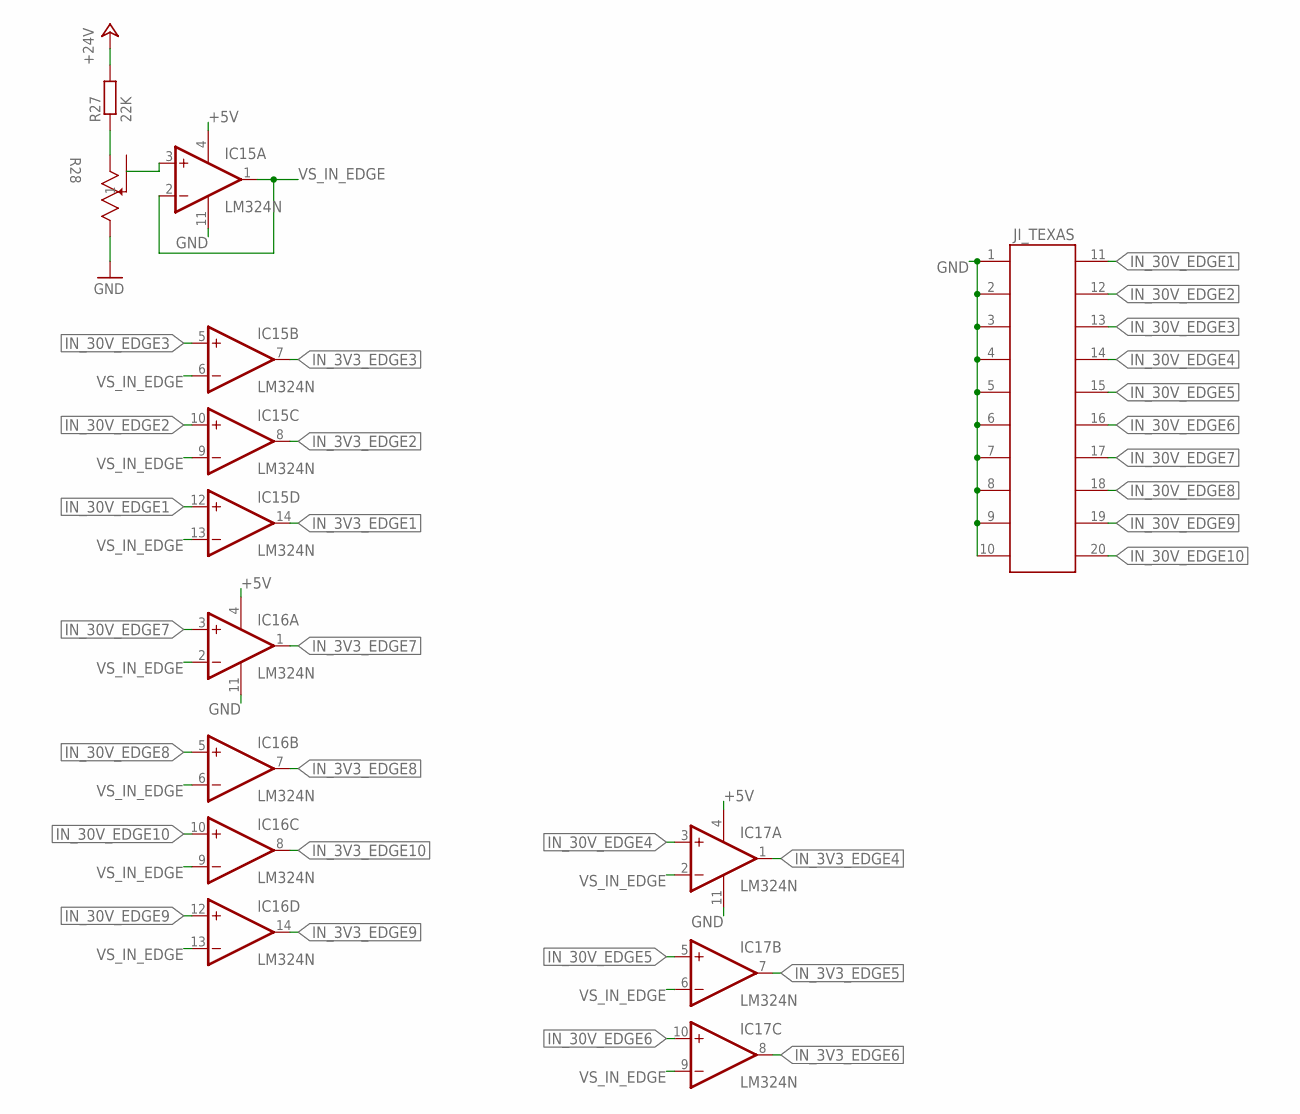
[picture p65: schematic comando 24V.sch, sheet 11]

Parts:
IC15, IC16, IC17: LM324N; DIL14
JI_TEXAS: 61202021621
R27: 22K; 0207/10
R28: VS_EDGE_ADJ; RES3_64W_TTE

Connections:
+5V: IC15.4 (V+), IC16.4 (V+), IC17.4 (V+); also elsewhere on the board
+24V: R27.2; also elsewhere on the board
GND: IC15.11 (V-), IC16.11 (V-), IC17.11 (V-), JI_TEXAS.1, JI_TEXAS.2 (3), JI_TEXAS.3 (5), JI_TEXAS.4 (7), JI_TEXAS.5 (9), JI_TEXAS.6 (11), JI_TEXAS.7 (13), JI_TEXAS.8 (15), JI_TEXAS.9 (17), JI_TEXAS.10 (19), R28.3; also elsewhere on the board
IN_3V3_EDGE1: IC15.14 (OUT); also elsewhere on the board
IN_3V3_EDGE2: IC15.8 (OUT); also elsewhere on the board
IN_3V3_EDGE3: IC15.7 (OUT); also elsewhere on the board
IN_3V3_EDGE4: IC17.1 (OUT); also elsewhere on the board
IN_3V3_EDGE5: IC17.7 (OUT); also elsewhere on the board
IN_3V3_EDGE6: IC17.8 (OUT); also elsewhere on the board
IN_3V3_EDGE7: IC16.1 (OUT); also elsewhere on the board
IN_3V3_EDGE8: IC16.7 (OUT); also elsewhere on the board
IN_3V3_EDGE9: IC16.14 (OUT); also elsewhere on the board
IN_3V3_EDGE10: IC16.8 (OUT); also elsewhere on the board
IN_30V_EDGE1: IC15.12 (+IN), JI_TEXAS.11 (2)
IN_30V_EDGE2: IC15.10 (+IN), JI_TEXAS.12 (4)
IN_30V_EDGE3: IC15.5 (+IN), JI_TEXAS.13 (6)
IN_30V_EDGE4: IC17.3 (+IN), JI_TEXAS.14 (8)
IN_30V_EDGE5: IC17.5 (+IN), JI_TEXAS.15 (10)
IN_30V_EDGE6: IC17.10 (+IN), JI_TEXAS.16 (12)
IN_30V_EDGE7: IC16.3 (+IN), JI_TEXAS.17 (14)
IN_30V_EDGE8: IC16.5 (+IN), JI_TEXAS.18 (16)
IN_30V_EDGE9: IC16.12 (+IN), JI_TEXAS.19 (18)
IN_30V_EDGE10: IC16.10 (+IN), JI_TEXAS.20
unnamed: R27.1, R28.1
unnamed: IC15.3 (+IN), R28.2
VS_IN_EDGE: IC15.1 (OUT), IC15.2 (-IN), IC15.6 (-IN), IC15.9 (-IN), IC15.13 (-IN), IC16.2 (-IN), IC16.6 (-IN), IC16.9 (-IN), IC16.13 (-IN), IC17.2 (-IN), IC17.6 (-IN), IC17.9 (-IN)

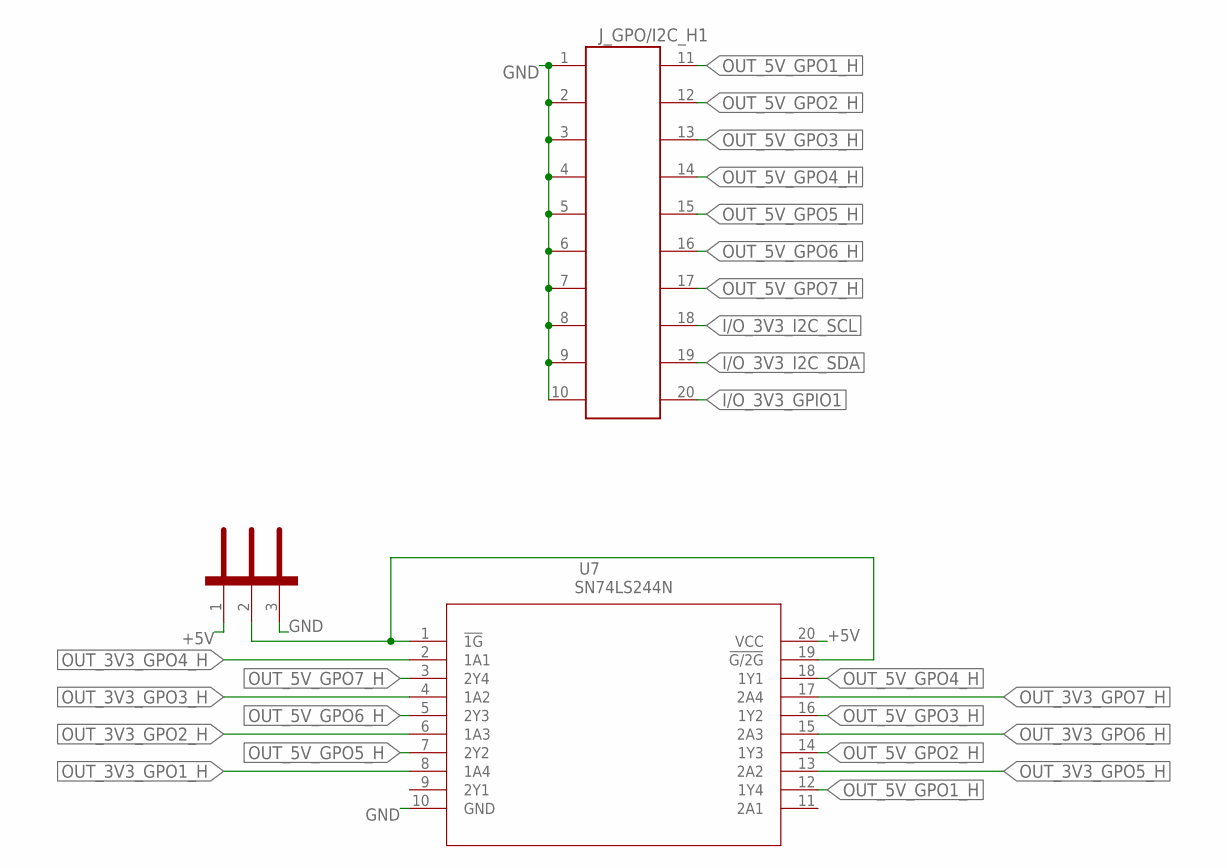
[picture p66: schematic comando 24V.sch, sheet 12]

Parts:
EN_GPO_H: STRIP_3
J_GPO/I2C_H1: 61202021621
U7: SN74LS244N; N20

Connections:
+5V: EN_GPO_H.1, U7.20 (VCC); also elsewhere on the board
GND: EN_GPO_H.3, J_GPO/I2C_H1.1, J_GPO/I2C_H1.2 (3), J_GPO/I2C_H1.3 (5), J_GPO/I2C_H1.4 (7), J_GPO/I2C_H1.5 (9), J_GPO/I2C_H1.6 (11), J_GPO/I2C_H1.7 (13), J_GPO/I2C_H1.8 (15), J_GPO/I2C_H1.9 (17), J_GPO/I2C_H1.10 (19), U7.10 (GND); also elsewhere on the board
I/O_3V3_GPIO1: J_GPO/I2C_H1.20; also elsewhere on the board
I/O_3V3_I2C_SCL: J_GPO/I2C_H1.18 (16); also elsewhere on the board
I/O_3V3_I2C_SDA: J_GPO/I2C_H1.19 (18); also elsewhere on the board
unnamed: EN_GPO_H.2, U7.1 (!1G), U7.19 (!G/2G)
OUT_3V3_GPO1_H: U7.8 (1A4); also elsewhere on the board
OUT_3V3_GPO2_H: U7.6 (1A3); also elsewhere on the board
OUT_3V3_GPO3_H: U7.4 (1A2); also elsewhere on the board
OUT_3V3_GPO4_H: U7.2 (1A1); also elsewhere on the board
OUT_3V3_GPO5_H: U7.13 (2A2); also elsewhere on the board
OUT_3V3_GPO6_H: U7.15 (2A3); also elsewhere on the board
OUT_3V3_GPO7_H: U7.17 (2A4); also elsewhere on the board
OUT_5V_GPO1_H: J_GPO/I2C_H1.11 (2), U7.12 (1Y4)
OUT_5V_GPO2_H: J_GPO/I2C_H1.12 (4), U7.14 (1Y3)
OUT_5V_GPO3_H: J_GPO/I2C_H1.13 (6), U7.16 (1Y2)
OUT_5V_GPO4_H: J_GPO/I2C_H1.14 (8), U7.18 (1Y1)
OUT_5V_GPO5_H: J_GPO/I2C_H1.15 (10), U7.7 (2Y2)
OUT_5V_GPO6_H: J_GPO/I2C_H1.16 (12), U7.5 (2Y3)
OUT_5V_GPO7_H: J_GPO/I2C_H1.17 (14), U7.3 (2Y4)

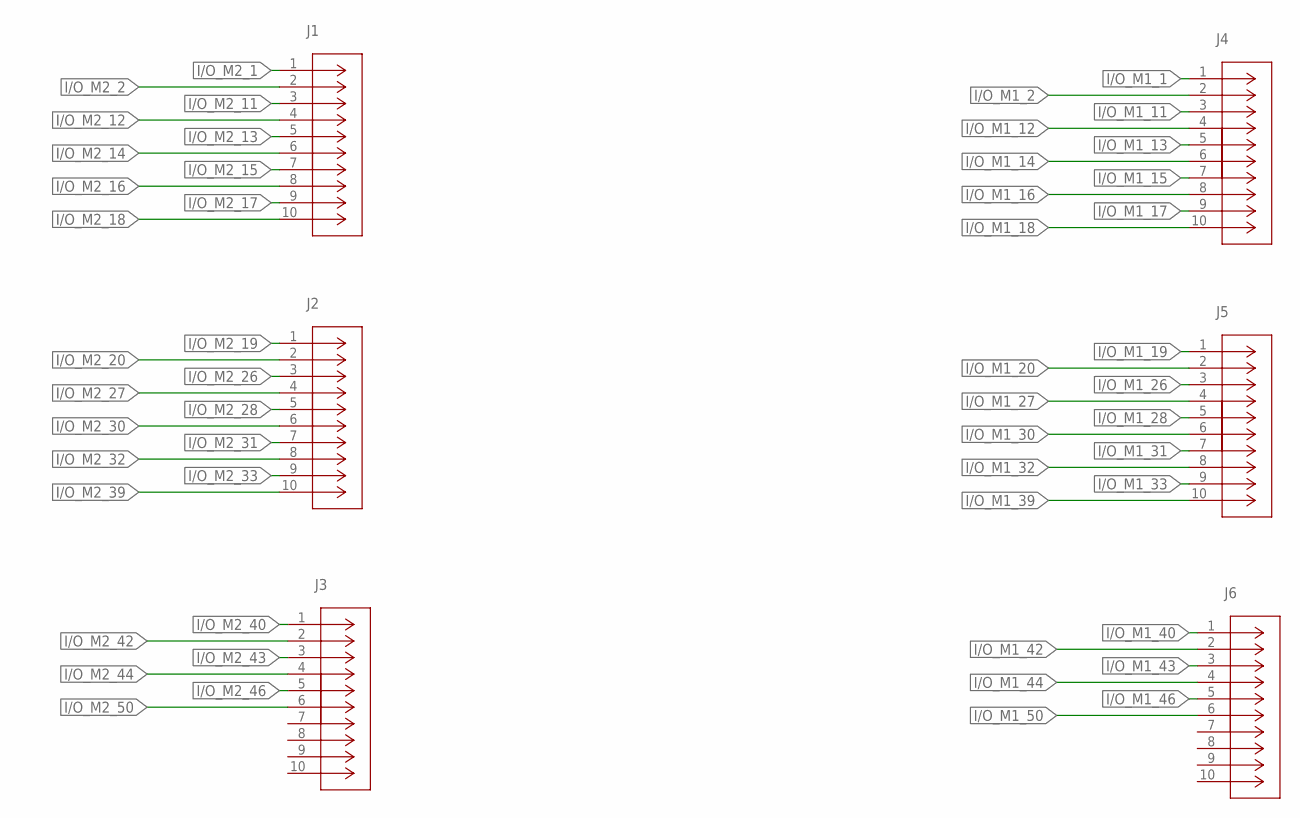
[picture p67: schematic comando 24V.sch, sheet 13]

Parts:
J1, J2, J3, J4, J5, J6: 61201021621; CONN_61201021621_WRE

Connections:
I/O_M1_1: J4.1; also elsewhere on the board
I/O_M1_2: J4.2; also elsewhere on the board
I/O_M1_11: J4.3; also elsewhere on the board
I/O_M1_12: J4.4; also elsewhere on the board
I/O_M1_13: J4.5; also elsewhere on the board
I/O_M1_14: J4.6; also elsewhere on the board
I/O_M1_15: J4.7; also elsewhere on the board
I/O_M1_16: J4.8; also elsewhere on the board
I/O_M1_17: J4.9; also elsewhere on the board
I/O_M1_18: J4.10; also elsewhere on the board
I/O_M1_19: J5.1; also elsewhere on the board
I/O_M1_20: J5.2; also elsewhere on the board
I/O_M1_26: J5.3; also elsewhere on the board
I/O_M1_27: J5.4; also elsewhere on the board
I/O_M1_28: J5.5; also elsewhere on the board
I/O_M1_30: J5.6; also elsewhere on the board
I/O_M1_31: J5.7; also elsewhere on the board
I/O_M1_32: J5.8; also elsewhere on the board
I/O_M1_33: J5.9; also elsewhere on the board
I/O_M1_39: J5.10; also elsewhere on the board
I/O_M1_40: J6.1; also elsewhere on the board
I/O_M1_42: J6.2; also elsewhere on the board
I/O_M1_43: J6.3; also elsewhere on the board
I/O_M1_44: J6.4; also elsewhere on the board
I/O_M1_46: J6.5; also elsewhere on the board
I/O_M1_50: J6.6; also elsewhere on the board
I/O_M2_1: J1.1; also elsewhere on the board
I/O_M2_2: J1.2; also elsewhere on the board
I/O_M2_11: J1.3; also elsewhere on the board
I/O_M2_12: J1.4; also elsewhere on the board
I/O_M2_13: J1.5; also elsewhere on the board
I/O_M2_14: J1.6; also elsewhere on the board
I/O_M2_15: J1.7; also elsewhere on the board
I/O_M2_16: J1.8; also elsewhere on the board
I/O_M2_17: J1.9; also elsewhere on the board
I/O_M2_18: J1.10; also elsewhere on the board
I/O_M2_19: J2.1; also elsewhere on the board
I/O_M2_20: J2.2; also elsewhere on the board
I/O_M2_26: J2.3; also elsewhere on the board
I/O_M2_27: J2.4; also elsewhere on the board
I/O_M2_28: J2.5; also elsewhere on the board
I/O_M2_30: J2.6; also elsewhere on the board
I/O_M2_31: J2.7; also elsewhere on the board
I/O_M2_32: J2.8; also elsewhere on the board
I/O_M2_33: J2.9; also elsewhere on the board
I/O_M2_39: J2.10; also elsewhere on the board
I/O_M2_40: J3.1; also elsewhere on the board
I/O_M2_42: J3.2; also elsewhere on the board
I/O_M2_43: J3.3; also elsewhere on the board
I/O_M2_44: J3.4; also elsewhere on the board
I/O_M2_46: J3.5; also elsewhere on the board
I/O_M2_50: J3.6; also elsewhere on the board

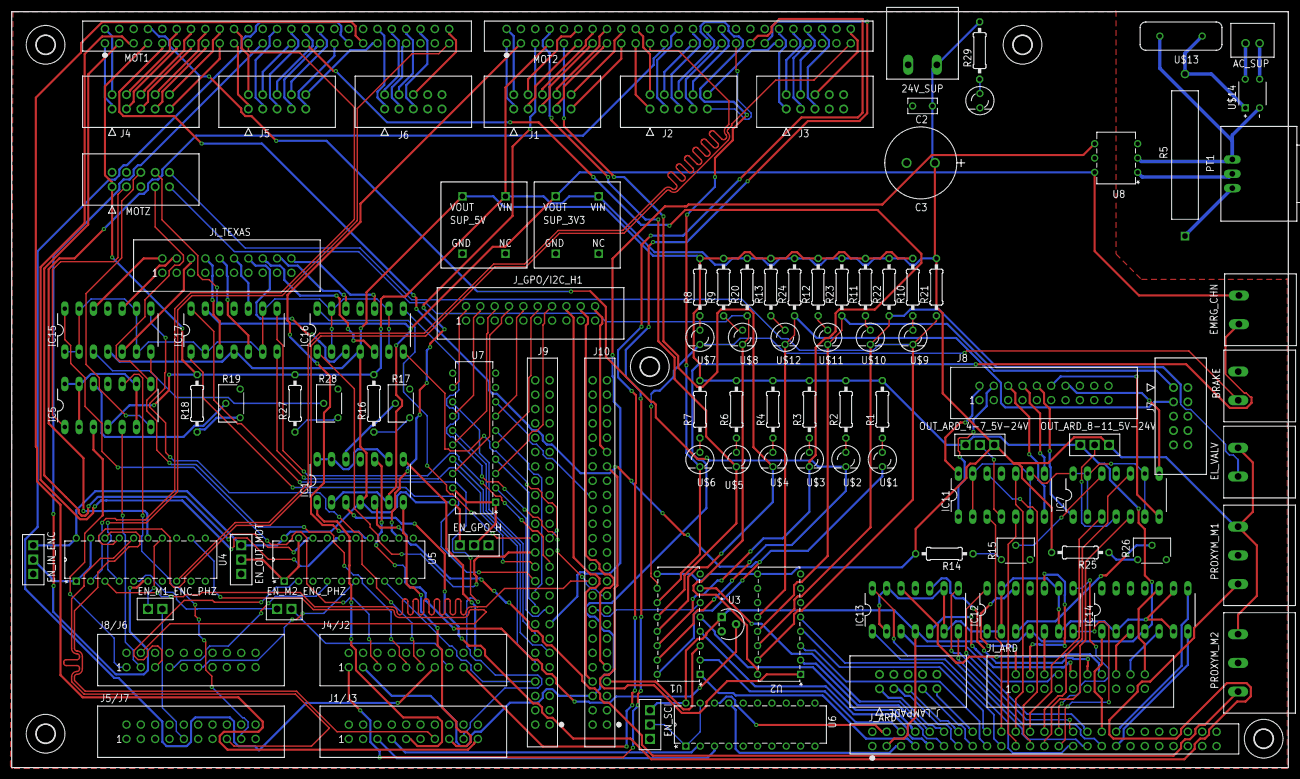
[picture p68: board comando 24V.brd from above]

Board: 2 copper layers, 226.1 x 133.9 mm, 109 parts (0 on the bottom side), 242 nets.

Other parts of the board:
U$16, U$17, U$18, U$19, U$20: 3,3
