baglia/ROSBOT-project/software/MICROCONTROLLER/TEXAS INSTRUMENTS HERCULES/CCS_workspace/Parser_PWM/include/GlobalVar.h

#ifndef GLOBALVAR_H
#define GLOBALVAR_H


#include "Point.h"
#include <stdbool.h>

typedef struct
{
  float mainAngle;
  float secondAngle;
  float dAngle;
} MotorAngle;

typedef struct
{
  unsigned int period;
  bool isPeriod;
  bool isEnd;
} Period;

extern int length1, length2, tolerance;
extern MotorAngle alpha, beta;
extern Point2D origin, actualPoint;
extern float maxSpeed, maxAccel, minSpeed;

bool isPointReachable(Point _point);

#endif
