baglia/ROSBOT-project/(notices)

Notices in the files:
parts and their libraries:
SCARA: COPYRIGHT: Copyright (C) 2018 Accelerated Designs. All rights reserved
SCARA: COPYRIGHT: Copyright (C) 2016 Accelerated Designs. All rights reserved
